igrowing/HA-Irrigator/hardware/irrigator box.stl

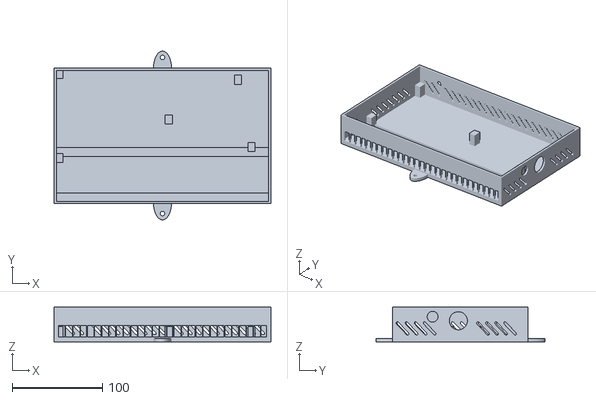
[picture p10: CAD file, 2026-07-20]
hardware/irrigator box.stl
240.0 x 186.7 x 38.7
