igrowing/HA-Irrigator/hardware/irrigator lid.stl

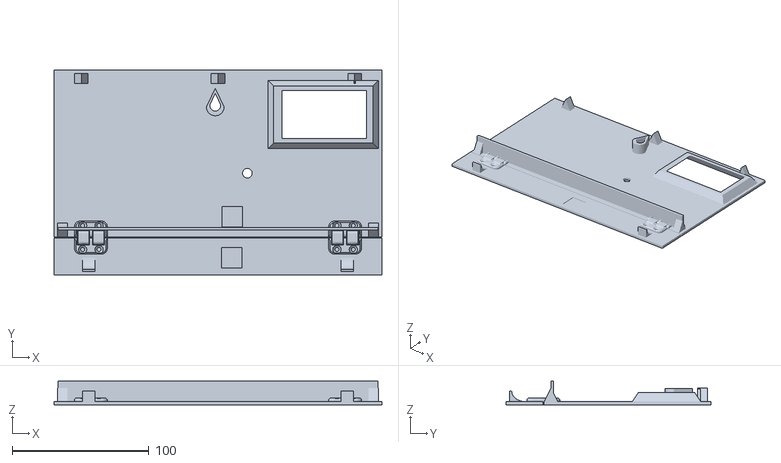
[picture p11: CAD file, 2026-07-20]
hardware/irrigator lid.stl
240.0 x 150.0 x 17.4
