igrowing/HA-Irrigator/docs/usage_homeassistant.md

# Home Assistant Usage

This is the end-user guide to the Garden tab once the HA package is installed. For installation steps (copying files, finding your device's MQTT prefix, dependencies, troubleshooting a package that won't load) see [integration.md](integration.md) — this page assumes that's done and focuses on what each part of the dashboard does day to day, plus how it behaves under the hood (sync, offline queueing, entity naming) once it's running.

The Irrigator unit itself, screen showing an upcoming scheduled run

## Status & Manual Control

One card per pump/zone (pump first, disabled zones hidden): a toggle — its label is the zone's real name, never "Zone N" — and a 1–120 minute duration slider. Flip the toggle on to start a run for whatever the slider is currently set to; flip it off to stop. A "Remaining" row shows minutes left on whichever zone/pump is actually running (the device only ever runs one thing at a time).

Status & Manual Control cards, pump plus two zones with duration sliders

Toggling on calls `script.irrigator_start` (publishes `cmd/run` with the slider's current value); toggling off calls `script.irrigator_stop`. Cards for disabled zones hide themselves via a `conditional` card keyed on that zone's `enabled` flag from `settings.json`. The toggle (`switch.irrigator_zone_N`) and "Remaining" (`sensor.irrigator_zone_N_remaining`) are two separate entities, both fed by `sensor.irrigator_watering_state` (the device's `/state` topic) — template `switch` entities can't carry a custom `remaining_min` attribute (see the header comment above the `template: switch:` block in `../homeassistant/packages/irrigator.yaml`), so it's its own sensor. Since the device only ever runs one zone/pump at a time, `/state` reports that single active one, and every switch/sensor pair is gated on "is this the zone `/state` currently says is active" — real minutes for whichever one is actually running, `0` for all others (shown rather than hidden, since entities-card rows can't be individually conditional).

**One deliberate exception**: `switch.irrigator_pump`/`switch.irrigator_zone_N` use `"Irrigator Zone N"` as their fallback instead of the `#N (no name)` placeholder used elsewhere (see **Settings** below). Reason: template `switch` entities don't support `default_entity_id` (see `irrigator.yaml`'s `template:` header comment), so nothing pins their `entity_id` directly — but `entity_id` is only ever auto-generated *once*, at first-ever creation, from whatever `name:` happens to render to at that exact moment. On a fresh deploy `sensor.irrigator_settings` has no data yet at that moment, so the fallback text is what actually gets slugified into the permanent `entity_id` — it has to slug to exactly `switch.irrigator_zone_N` (what everything else in this package references), which `#N (no name)` does not. This is a one-time, first-boot-only concern: every later re-render (once real names arrive, moments later) only updates the *displayed* name, never the already-frozen `entity_id` — so in practice you should only ever see "Irrigator Zone N" flash briefly right after the very first deploy, then never again. See "Troubleshooting" below if toggles/remaining time never reflect real state.

## History

A 7-day timeline (`history-graph`, `hours_to_show: 168`), one row per zone/pump, showing exactly when each ran. It references the switches directly — their name is live-templated (see **Status & Manual Control** above), and `history-graph` shows an entity's current registered name automatically, so no dashboard-side templating is needed here.

## Schedule

A read-only table of the device's current weekly schedule, sortable by day/zone/name/start/duration/active, plus an editor panel below it: pick an existing row (or "+ Add new"), set zone/day/start time/duration/active, then **Save** or **Delete**. Every edit republishes the whole schedule to the device — there's no partial update.

Device Schedule table, sorted by day

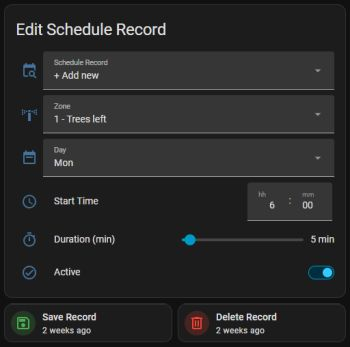
[picture p12: docs/edit schedule.jpg]
Edit Schedule Record panel, editing an existing record


Zone names, everywhere they appear (Status, History, Schedule, Settings), come from exactly one place: `sensor.irrigator_settings`'s `zone_names` attribute, sourced from the device's `settings.json` — never a hardcoded name. Until that sensor has real data, most zone-name fields show `#N (no name)` instead — a deliberate placeholder that doesn't look like a real name, so it's obvious at a glance when the device data hasn't loaded rather than silently passing off a fallback as if it were configured. See "Troubleshooting" below if you see that placeholder persist.

### How the schedule editor works

This section was originally built on Home Assistant's Local Calendar integration (`calendar.irrigator_zone_1`..`_11`, one event per schedule block, edited via the calendar's own dialog). That design turned out to be fundamentally blocked: `calendar.create_event` accepts `summary`, `description`, `start_date_time`/`end_date_time` (or `start_date`/`end_date`/`in`), and `location` — **no `rrule` field at all**. True weekly recurrence is a capability of the calendar dialog's own frontend code, not something exposed through any callable service, so no automation could ever have created a genuinely-recurring event, and a schedule made of only non-recurring single events would have silently gone stale the next time `calendar.get_events` scanned "this calendar week" and found nothing. If you still have the 11 Local Calendar integration entries from an earlier version of this setup, they're no longer referenced anywhere in this package and can be deleted (Settings > Devices & Services > Local Calendar).

The replacement edits `schedule.json`'s records directly — no calendar entities involved:

- **`sensor.irrigator_schedule`** mirrors whatever schedule the device currently has loaded (its   `records` attribute is a plain list of `{zone, day_of_week, start_time, duration_min, active}`   objects, same shape as `../ha.md`'s Schedule JSON example) — shown as the read-only "Device Schedule" table at the top of the Schedule section, sortable via the "Sort Schedule Table By" dropdown (see below for why that's a dropdown and not a clickable column header).
- **The editor panel** (`input_select.irrigator_schedule_picker` down to `input_boolean.irrigator_edit_active`) lets you pick an existing record or "+ Add new", edit zone/day/start time/duration/active, then press **"Save Schedule Record"** or **"Delete Schedule Record"**. Both scripts (`script.irrigator_schedule_save`/`_delete` in `../homeassistant/packages/irrigator.yaml`) read the *entire* current record list, apply one change (replace/append/remove), and republish the whole array to `cmd/upload/schedule.json` — same whole-file-replace contract every other write to this device uses. The picker's `[<index>]` prefix and the table's `#` column both refer to the same position in `sensor.irrigator_schedule`'s `records` list, so you can match a table row to its editor entry at a glance; two automations in `../homeassistant/packages/irrigator_automations.yaml` ("...rebuild schedule editor dropdown options" / "...load selected schedule record...") keep the picker's options and the panel's fields in sync with real device data.
- **Per-record "active" pause/resume is preserved directly** — unlike the calendar design, `active` is just a checkbox in the editor panel, matching the field's real meaning in `schedule.json`.
- **255-record cap.** `script.irrigator_schedule_save` checks the resulting record count against the firmware's `SCHEDULE_MAX_RECORDS` (255) before publishing, and raises a persistent notification instead of sending an oversized array that the firmware would whole-file-reject anyway.
- **No true click-a-column-header-to-sort.** A stock `markdown` card can't run JavaScript (HA sanitizes it out), so a real clickable sort isn't buildable without a custom/HACS card. `input_select.irrigator_schedule_sort_by` is the native equivalent — it only reorders the table's Jinja rendering, never touches `sensor.irrigator_schedule` or the device.
- **Dropdown options are built via Jinja's native-type list rendering** (a `namespace()` accumulator ending in a single bare `{{ ns.items }}` expression, which HA's template engine returns as an actual list rather than a stringified one) — this is a standard, common HA automation pattern, but if either `input_select.irrigator_schedule_picker` or `input_select.irrigator_edit_zone` ever shows one garbled option instead of several clean ones, check "Irrigator - rebuild schedule editor dropdown options" in `../homeassistant/packages/irrigator_automations.yaml` first.

## Settings

Settings section, watering adjustment, weather data, and zone name/enabled rows

The schedule-active toggle and watering-percentage number are live MQTT entities (direct topic round-trip). Zone name/enabled and default-manual-duration republish the *entire* `settings.json` via `script.irrigator_publish_settings` instead — a partial payload would be dangerous, since the firmware fills any missing field with its factory default, not with the value already on flash. This is guarded against the same virgin-deploy race as the schedule tab, but automatically rather than with a manual toggle — see **How the download/sync model works** below. Current-sensor calibration is separate from all of this — see **Current-Sensor Calibration** below.

- **Schedule Active** / **Watering Percentage** — direct controls, same as the device's own rotary menu. Watering Percentage is also the value weather-based auto-adjustment works once a day (see  below) — think of your own edits here as a same-day override, since the next daily cycle  recalculates and overwrites it. Although control on **Watering Percentage** is provided, the HA-Irrigateor takes care about it by Auto-adjustment algorithm.
- **Zone name / Enabled**, one row per zone — renaming or disabling a zone here updates the device  immediately (a disabled zone can't be started manually, by schedule, or via MQTT until  re-enabled). Disabling the zone is useful if you want to protect yourself for mistakes of setting irrelevant schedule. It also temporarily useful when you need to repair an electric or water cisruit of a certain zone or just perform mainenance on it.
- **Default Manual Duration** — how long a manual zone/pump run lasts when started without picking a duration.
- **Current-Sensor Calibration** — read-only **Valve Base Level** / **Pump Base Level** (from the last settings.json download), four **Alert Pump Under-current** / **Alert Pump Over-current** / **Alert Valve Under-current** / **Alert Valve Over-current** toggles, an **Irrigator Calibrate** button that captures fresh baselines (needs an active watering run — valve open, not just the pump alone — or the device rejects it), and the live **Last Calibration Response**. The base levels are device-owned — there's no HA control that edits them directly, only the button that triggers a fresh capture on the device; there's no local `input_number` for either value, editing them any other way isn't possible by design. See [technical.md](technical.md)'s **cmd/calibrate** section for what the base level means and how over/undercurrent alerting uses it.
  - The four alert toggles (default **on**) each independently enable/disable one of pump-over-current / pump-under-current / valve-over-current / valve-under-current alerting — same four switches as the device's own rotary Settings menu, right above **Calibrate CS** there too (see [usage_irrigator.md](usage_irrigator.md)'s **How to control over-current and under-current alerts**). Flipping one republishes the full `settings.json`, same as any other Settings-tab field. A toggle only has an effect once its sensor has actually been calibrated (a `0` base level means "never calibrated" — the underlying check is skipped regardless of the toggle).
  - Every alert that trips (`sensor.irrigator_last_alert`, or `.../alert` directly) is forwarded automatically to WhatsApp (`notify.greenapi`) and the Logbook by the "Irrigator - forward current-fault alerts to WhatsApp + logbook" automation in `../homeassistant/packages/irrigator_automations.yaml` — no dashboard action needed to receive them. That automation assumes a `notify.greenapi` service already exists in your Home Assistant (the [GreenAPI](https://green-api.com) WhatsApp integration, or any other notify target you rename it to) — if it doesn't, the automation's `notify.greenapi` step fails silently in the log without blocking the `logbook.log` step alongside it.
- **Auto-adjustment** — the master on/off switch for the whole weather-based feature (the daily percentage recalculation, including the forecast-rain term), topmost in the **Auto-adjustment  Weather Data** card. Turning it off freezes watering at whatever **Watering Percentage** is  currently set to — same as if the feature didn't exist — until turned back on. Mirrors the  device's own rotary UI, where it's the second item in the Settings menu (right after Schedule Active, since auto-adjustment only makes sense while the schedule itself is active).
- **Auto-adjustment Upper Limit** / **Lower Limit** — the range the daily weather-based adjustment  is allowed to move **Watering Percentage** within (defaults 200% / 40%). If the computed value  would fall below **Lower Limit**, that day's watering is skipped entirely (0%) instead of being  clamped up to it. The **Upper Limit** is intended to save an excessive bill on watering, trading off a bit the health of the plants.
- **Forecast Rain Probability Threshold** — the probability at or above which the rain in the forecast is counted, in full, as already fallen when the day's watering is calculated (default 70%). See [usage_irrigator.md](usage_irrigator.md)'s **Step 1** for the worked examples.
- **City** / **Coordinates** — read-only, whatever the device auto-detected from its IP address the  first time it came online with no saved location (there's no way to correct these from HA if the  IP-based lookup is inaccurate for your network — see [technical.md](technical.md)'s **Known limitations**). There's no HA equivalent of the device's own "Last update" field — that date lives in the  device's RAM only, never written to `settings.json`, so it's visible on the device's own rotary  UI Settings menu but not in Home Assistant.
- **Backup from the Irrigator Device** button (`button.irrigator_refresh_from_device`) calls `script.irrigator_backup_from_device` to force-request `/status` plus both `settings.json` and `schedule.json` on demand, regardless of virgin status — useful if you suspect drift or want to double-check after a manual device-side change. It also now writes both files to `/config/irrigator_backups/` on the HA host (a timestamped copy plus a `_latest.json` HA itself reads back from) — see **Backing up and restoring settings/schedule** below.
- **Restore to the Irrigator Device** button (`button.restore_to_the_irrigator_device`) uploads the files the button above last wrote back to the device, verbatim — see the same section below.

## Water Flow Sensing

The **Water Flow** card (Garden tab) shows the TUF-2000M flow meter's own running
total (`sensor.irrigator_flow_total`, L — the meter's lifetime totalizer, not a per-zone breakdown).
The live flow rate is deliberately not sent to Home Assistant; publish `cmd/meter` to see it. The **Water Consumption** card group
right below it splits that same lifetime volume per zone (`sensor.irrigator_zone_N_water_total`,
disabled zones' cards hidden the same way the Status section hides them) plus **Other**
(`sensor.irrigator_other_water_total` — flow measured while every valve is closed, e.g. a hose bib
spliced into the irrigation line or a leak; not a second whole-house meter), each shown as a rolling
24-hour total with a **History** button opening HA's native history dialog. All of these reset to 0
on a device reboot (RAM-only counters, like most of this project's runtime state) — HA's own
long-term statistics smooth over that reset rather than miscounting it as negative consumption.

Each completed run's own water use shows up as the `volume` attribute on
`sensor.irrigator_watering_state` (liters) the instant that run's `/state` message reports
`on: false` — `0` the rest of the time (while a zone/pump is running, or fully idle), so read it
right as a run ends rather than looking it up later; there's no dedicated dashboard card for it yet.

### Settings

The **Flow-Meter Anomaly Check** card (next to **Current-Sensor Calibration**) has:

- **Enabled** — master on/off for the anomaly check specifically (see below). Doesn't affect the
  Water Flow / Water Consumption telemetry above, which keeps reporting regardless of this toggle.
- **Expected Flow Rate** (L/min) — the steady-state rate the anomaly check compares live readings
  against. `0` (the default) means "not configured" — the check doesn't run until you set a real
  value here, e.g. the `flow_rate_lpm` that `cmd/meter` reports during a normal run.

Both fields republish the full `settings.json`, same as every other Settings-tab field (see **How
the download/sync model works** below).

### Flow anomaly alerts

While a zone is watering, the device compares the live flow rate against **Expected Flow Rate** and
warns you if it's noticeably higher or lower than normal:

- **Flow high** — a stuck-open valve elsewhere on the line, a burst pipe, or a valve letting through
  more than it should.
- **Flow low** — a clogged emitter/nozzle, a partially closed valve, or a valve that didn't fully
  open.

Like the current-sensor faults, each of these trips at most once per zone per calendar day, and is
forwarded automatically to WhatsApp and the Logbook by the same "Irrigator - forward current-fault
alerts to WhatsApp + logbook" automation (it matches on any `/alert` payload with a `fault` key
defined, and `flow_high`/`flow_low` use that same shape) — see **Settings** above for the
notify-service caveat. See [usage_irrigator.md](usage_irrigator.md)'s **Water Flow Sensing** section
for what these mean physically.

A Modbus communication failure (the flow meter not answering at all — a loose RS-485 connection, a
disconnected cable, a wedged transceiver) is a separate, lower-level alert
(`{"flow_meter":"failed",...}`, no `fault` key) that reaches `sensor.irrigator_last_alert` but is
**not** forwarded to WhatsApp — see [technical.md](technical.md)'s **Water flow sensing (TUF-2000M)**
section.

## How the download/sync model works

Per `../ha.md`'s preface, settings.json and schedule.json are requested from the device via MQTT —
but only when HA doesn't already have a representation, not on a recurring poll:

- **`sensor.irrigator_settings`** subscribes to `.../download/settings.json` (the response topic for `cmd/download/settings.json`) and simply reflects whatever last landed there — from an explicit request, or anyone else asking the device for it. There's no topic the device pushes settings.json to on its own, but there doesn't need to be: settings.json only ever changes via HA in practice (the local rotary/display menu has no settings-editing screens — see `../irrigator.md`'s menu spec), so once HA has a copy, HA's own edits (via `script.irrigator_publish_settings`) are the only thing that can make it stale, and HA already knows about those. "Irrigator - republish settings on local helper change" (the automation that calls that script) is itself guarded on this sensor already holding real data, which is what closes the settings-side virgin-deploy race automatically: the 15 Settings-tab helpers are created fresh at their YAML `initial:` placeholder values on a virgin deploy, and that creation fires a state-changed event just like a real edit would. This same sync automation also "self-sets" `switch.irrigator_schedule_active` (a `template:` entity — see **Offline command queue** below — whose `state:` reads the read-only `binary_sensor.irrigator_scheduled_state` MQTT echo sensor bound to `/scheduled`, which only ever gets a value when someone actively changes it, never as part of a passive settings download, so without this it'd sit blank on every fresh boot until manually touched) and `input_number.irrigator_watering_percentage` (a plain local helper, same as every other Settings-tab field — no echo dance needed there).
- **`sensor.irrigator_schedule`** is a trigger-based template sensor listening on *two* topics: `.../schedule` (which the device pushes on every change, whether from an HA upload or the device's own rotary/display menu) and `.../download/schedule.json` (the request/response topic). Since the device already pushes on every change, this sensor stays current on its own after the first value arrives — no polling needed.
- **"Irrigator - request initial data on virgin deploy"** (in `../homeassistant/packages/irrigator_automations.yaml`) fires both on HA startup AND whenever `binary_sensor.irrigator_online` turns "on" (covers the device reconnecting to the broker after an HA restart, which a startup-only trigger would miss entirely if the device isn't back online yet at that exact moment), and checks each of the two sensors independently: if either is still `unknown` (never received a value), it publishes an empty payload to that file's `cmd/download/...` topic to prime it. Once primed, it isn't re-requested automatically again.
- The **"Backup from the Irrigator Device"** button (`button.irrigator_refresh_from_device`) calls `script.irrigator_backup_from_device` to force-request `/status` plus both files on demand, regardless of virgin status — useful if you suspect drift or want to double-check after a manual device-side change.

## Backing up and restoring settings/schedule

- **"Backup from the Irrigator Device"** requests fresh `settings.json`/`schedule.json` from the device, waits (up to 15s each) for the responses, and writes each one — the exact bytes the device sent, not a re-serialized copy — to `/config/irrigator_backups/` on the HA host: `settings_<timestamp>.json` / `schedule_<timestamp>.json` for history, plus `settings_latest.json` / `schedule_latest.json` that Restore always reads. A device that answers one request but not the other (e.g. it reboots mid-response) still gets whichever one it did answer backed up — not an all-or-nothing failure. If a request times out, a persistent notification says so and the previous backup (if any) is left untouched.
- **"Restore to the Irrigator Device"** uploads `settings_latest.json`/`schedule_latest.json` back to the device via `cmd/upload/settings.json`/`cmd/upload/schedule.json` — the same verbatim bytes that were backed up, not a reconstruction from the Settings-tab helpers (that's what editing a field and letting `script.irrigator_publish_settings` republish does; it can only ever cover the fields those helpers expose). Routed through the offline command queue like every other device-bound write (see **Offline command queue** below), so a restore requested while the device is briefly unreachable is queued and retried rather than dropped. The dashboard button asks for confirmation first, since it overwrites the device's live settings and schedule with whatever was last backed up — if that's stale, restoring it reverts real changes.
  - `settings.json`'s device-owned fields — `schedule_active` and the two current-sensor calibration bases — are never actually changed by this: the firmware overwrites whatever an upload carries for them with its own current values before persisting (see [technical.md](technical.md)'s **JSON file formats**), so restoring an old backup can't accidentally flip the schedule off or wipe a calibration.
  - If no backup has ever been taken (`/config/irrigator_backups/` doesn't exist yet, or a file is empty), Restore says so via a persistent notification for that file and leaves the device untouched rather than uploading empty content.
  - Restore deliberately does not auto-refresh `sensor.irrigator_settings`/`sensor.irrigator_schedule` afterward — if the device was offline and the upload only got queued, an immediate re-backup would capture the device's *old* content and overwrite the very backup file Restore just read from. Press **"Backup from the Irrigator Device"** afterward to confirm the restore actually landed.
- Both buttons need a POSIX shell (`sh`) and standard coreutils (`cat`, `tee`, `mkdir`, `date`) on the HA host to read/write those files — true for Home Assistant OS, Supervised, and the official Docker image. If your `command_line:`/`shell_command:` entities show as unavailable, this is the first thing to check.

## Offline command queue

The garage's Wi-Fi is flaky enough that the device drops off `.../online` often, and the pre-queue behavior was every manual-control switch greying out via `availability:` whenever that happened — so all the Run switches and Schedule Active carry **no** `availability:` binding at all now; they're always clickable. Writing to any of them while the device is offline doesn't get lost — it's queued and retried until it actually reaches the device. Watering Percentage is a plain `input_number` helper (not gated by `availability:` either, since it isn't an MQTT entity at all) — editing it goes out via the same full-settings republish as every other Settings-tab field, which is itself queued the same way when offline:

- **`script.irrigator_enqueue_or_publish`** (`topic`, `payload`) is the one chokepoint every device-bound write goes through — `irrigator_start`, `irrigator_stop`, `irrigator_stop_all`, `irrigator_test_all`, `irrigator_publish_settings`, `irrigator_schedule_save`, `irrigator_schedule_delete`, and the `turn_on`/`turn_off` of the Schedule Active template switch above. If `binary_sensor.irrigator_online` is `on`, it publishes immediately — same latency as before this existed. If not, it fires an `irrigator_queue_push` event instead of publishing.
- **`sensor.irrigator_command_queue`** is a trigger-based template sensor that accumulates `{topic, payload}` entries in its `items` attribute, self-referencing its own previous value via `this.attributes.items` on every `irrigator_queue_push` (append one) or `irrigator_queue_pop` (drop the leading `count` entries). This lives as an *attribute*, not an entity `state` string, specifically so it isn't subject to HA's 255-character state-value limit — a queued `cmd/upload/settings.json` or `cmd/upload/schedule.json` payload can be several hundred bytes to a few KB, and a plain `input_text` helper couldn't hold that.
- **"Irrigator - flush pending command queue"** (in `../homeassistant/packages/irrigator_automations.yaml`) drains the queue whenever the device is reachable: triggered both by the online transition (fastest path) and a 30-second `time_pattern` safety net, so it keeps retrying for as long as the device stays online and anything remains queued — not just a single attempt on reconnect. It pops exactly one item at a time, immediately after publishing it, and re-checks `binary_sensor.irrigator_online` before every iteration — so a disconnect mid-batch stops the loop right there instead of firing the rest of a stale batch at a device that already stopped listening, and only items that actually got published are ever removed from the queue.
- There's no per-command delivery acknowledgement from the device for `cmd/run` / `cmd/stop` / `cmd/scheduled` / `cmd/upload/settings.json` (see [technical.md](technical.md)'s MQTT section) — `cmd/#` is delivered at QoS 0 in practice, and the broker can't hold QoS-0 messages for a disconnected client even with a persistent session. "Published to the broker while `binary_sensor.irrigator_online` said on" is the best success signal available; it's not a true device-side confirmation.
- **`irrigator_schedule_save`/`_delete`** build their new record list on top of the *last still-queued* `cmd/upload/schedule.json` payload if one exists (found by filtering `sensor.irrigator_command_queue`'s `items` for that topic), falling back to `sensor.irrigator_schedule.records` only when nothing's queued. This matters because `sensor.irrigator_schedule` only updates from the device's own echo on `.../schedule` — which won't arrive until it's back online — so without this, a second offline edit would silently overwrite the first instead of building on it.
- The dashboard shows `sensor.irrigator_command_queue` (its `state` is the pending count) both as a conditional tile at the top of "Status & Manual Control" (only visible when non-zero) and in the Diagnostics list, so it's obvious when a command hasn't reached the device yet.

## Entity naming reference

- `switch.irrigator_pump`, `switch.irrigator_zone_1`..`_11` - manual on/off control, name tracks the zone's configured name live (see the "deliberate exception" note under **Status & Manual Control** above for why its fallback text differs from everywhere else).
- `sensor.irrigator_pump_remaining`, `sensor.irrigator_zone_1_remaining`..`_11_remaining` - remaining minutes of the current run, `0` unless this zone/pump is the one currently active.
- `input_number.irrigator_pump_duration`, `..._zone_N_duration` - manual run duration, 1-120 min.
- `switch.irrigator_schedule_active` - `template:` entity, state read from a read-only MQTT echo sensor, writes routed through the offline command queue (see **Offline command queue** above) rather than a direct `command_topic`.
- `switch.irrigator_auto_adjustment` - master on/off for weather-based auto-adjustment, same `template:`-entity-over-echo-sensor pattern as `switch.irrigator_schedule_active` immediately above (backed by `binary_sensor.irrigator_auto_adjustment_state`, writes via `cmd/auto_adjustment`).
- `input_text.irrigator_zone_N_name`, `input_boolean.irrigator_zone_N_enabled`, `input_number.irrigator_default_manual_duration`, `input_number.irrigator_watering_percentage` - settings that require a full `settings.json` republish (see **How the download/sync model works** above).
- `button.irrigator_calibrate` - publishes `cmd/calibrate`; requires an active watering run (valve open) or the device rejects it via `/alert`.
- `input_boolean.irrigator_alert_pump_uc`, `..._pump_oc`, `..._valve_uc`, `..._valve_oc` - the four over/under-current alert toggles (`settings.json`'s `Current_sensor` group), synced/republished the same way as the other Settings-tab helpers.
- `sensor.irrigator_calibration_result` - live `cmd/calibrate` response (fires once per sensor: `sensor`, `base_level`, `sample_count`, `burst_samples_mv` as attributes). Read-only, not part of the `settings.json` republish - `valve_current_base_level`/`pump_current_base_level` are device-owned, same as `latitude`/`longitude`/`city`.
- `input_select.irrigator_schedule_picker`, `input_select.irrigator_edit_zone`, `input_select.irrigator_edit_day`, `input_datetime.irrigator_edit_start_time`, `input_number.irrigator_edit_duration_min`, `input_boolean.irrigator_edit_active` - the schedule editor panel's fields - see **How the schedule editor works** above.
- `input_select.irrigator_schedule_sort_by` - display-only sort order for the "Device Schedule" table.
- `button.irrigator_refresh_from_device` ("Backup from the Irrigator Device"), `button.restore_to_the_irrigator_device` ("Restore to the Irrigator Device" - entity_id derived from its `name:`, not from `unique_id: irrigator_restore_from_backup`), `button.irrigator_save_schedule_record`, `button.irrigator_delete_schedule_record`, `button.irrigator_stop_all` - manual triggers for the corresponding scripts.
- `sensor.irrigator_status`, `sensor.irrigator_watering_state`, `sensor.irrigator_last_alert`, `sensor.irrigator_queue`, `sensor.irrigator_schedule`, `binary_sensor.irrigator_online` - read-only device telemetry.
- `sensor.irrigator_flow_total` (L, the meter's own lifetime totalizer) - TUF-2000M flow-meter telemetry on the "Water Flow" card, published once/minute while watering and threshold-triggered while idle (see **Water flow sensing (TUF-2000M)** in [technical.md](technical.md)).
- `sensor.irrigator_zone_1_water_total`..`_11_water_total`, `sensor.irrigator_other_water_total` - lifetime (since-boot) liters per zone plus "other", on the "Water Consumption" card group - see **Water Flow Sensing** above.
- `input_boolean.irrigator_flow_meter_enabled`, `input_number.irrigator_expected_flow_rate_lpm` - the flow anomaly check's on/off toggle and threshold, on the "Flow-Meter Anomaly Check" card - see **Water Flow Sensing** above.

## Troubleshooting

**Many/most entities from this package show "not found"/"unavailable" in Lovelace at once, right after setup** (e.g. `sensor.irrigator_status`, `button.irrigator_stop_all_button`, even ones with no data dependency of their own): this is almost always an installation problem — the *whole package file* failed to load, not that those specific entities are individually broken. See
[integration.md](integration.md)'s **Troubleshooting** section for the log line to check and the most common cause (a leftover `irrigatorF4` placeholder). Fix whatever the log names and reload/restart — don't chase individual "missing" entities until the log is clean.

**Zone names show `#N (no name)` everywhere instead of real names, or toggles never reflect the device's actual on/off/watering state:** (once the above is ruled out) both point to the same root cause - `sensor.irrigator_settings` and/or `sensor.irrigator_watering_state` never received real MQTT data. Check, in order:

1. **Developer Tools > States** - look up `sensor.irrigator_settings` and `sensor.irrigator_watering_state`. Do they show attributes at all (e.g. `Zones`, `zone`, `on`, `pump`), or none/blank? No attributes means no MQTT message has ever arrived on that entity's topic.
2. **Is `irrigatorF4` actually your device's real prefix everywhere?** A mismatched prefix in even one of the three files (see [integration.md](integration.md)'s **Step 1**) means that file's entities silently subscribe to a topic nothing publishes to.
3. **Developer Tools > MQTT > Listen to a topic** - subscribe to `irrigatorF4/#` (your real prefix) and trigger a manual run from the device or its local UI. You should see messages on `.../state` the instant a valve/pump starts or stops. If nothing appears there at all, the problem is upstream of HA entirely (device not connected to this broker, wrong broker, etc.) - if messages DO appear there but the entities still don't update, the entity's `state_topic` doesn't match what you just saw.
4. Press **"Backup from the Irrigator Device"** (`script.irrigator_backup_from_device` - pulls `/status`, `settings.json`, and `schedule.json` in one go) and re-check `sensor.irrigator_settings` - if `Zones` still doesn't populate after confirming step 3 shows a real reply on `.../download/settings.json`, compare that raw payload against the expected shape in **JSON file formats** in [technical.md](technical.md).

**Your editor/IDE flags things like `Device '*irrigator_device' does not exist` or `Device 'variables:' does not exist`:** these are not from Home Assistant - check **Settings > System > Logs**; if it's clean, the package loaded and parsed successfully, which wouldn't be possible if these were real errors. This is almost certainly a VS Code HA extension (or similar YAML-linting tool) misreading constructs it doesn't fully support: the `device: *irrigator_device` YAML *anchor alias* (resolved by the YAML parser before HA ever sees it, which some lightweight linters don't do), and nested `variables:` steps inside a `repeat:` block. Safe to ignore as long as the real HA log is clean.

**A schedule dropdown (`input_select.irrigator_schedule_picker` or `input_select.irrigator_edit_zone`) shows one long garbled option instead of several clean ones:** the automation that builds its option list relies on HA's Jinja native-type rendering returning an actual list from a `namespace()` accumulator (see **How the schedule editor works** above) - check "Irrigator - rebuild schedule editor dropdown options" in `../homeassistant/packages/irrigator_automations.yaml` and confirm via Developer Tools > Actions > "Input select: Set options" that a plain list, not a string, is what's being sent.

For the weather fields specifically: if **City**/**Coordinates** never populate, the device hasn't yet had a successful ip-api.com lookup — check its own Settings menu (rotary UI) or `sensor.irrigator_settings`'s `location_known` attribute; if that's `false`, the device is still retrying every 5 minutes (needs Wi-Fi, and ip-api.com being reachable).
