igrowing/HA-Irrigator/hardware/schematics.pdf

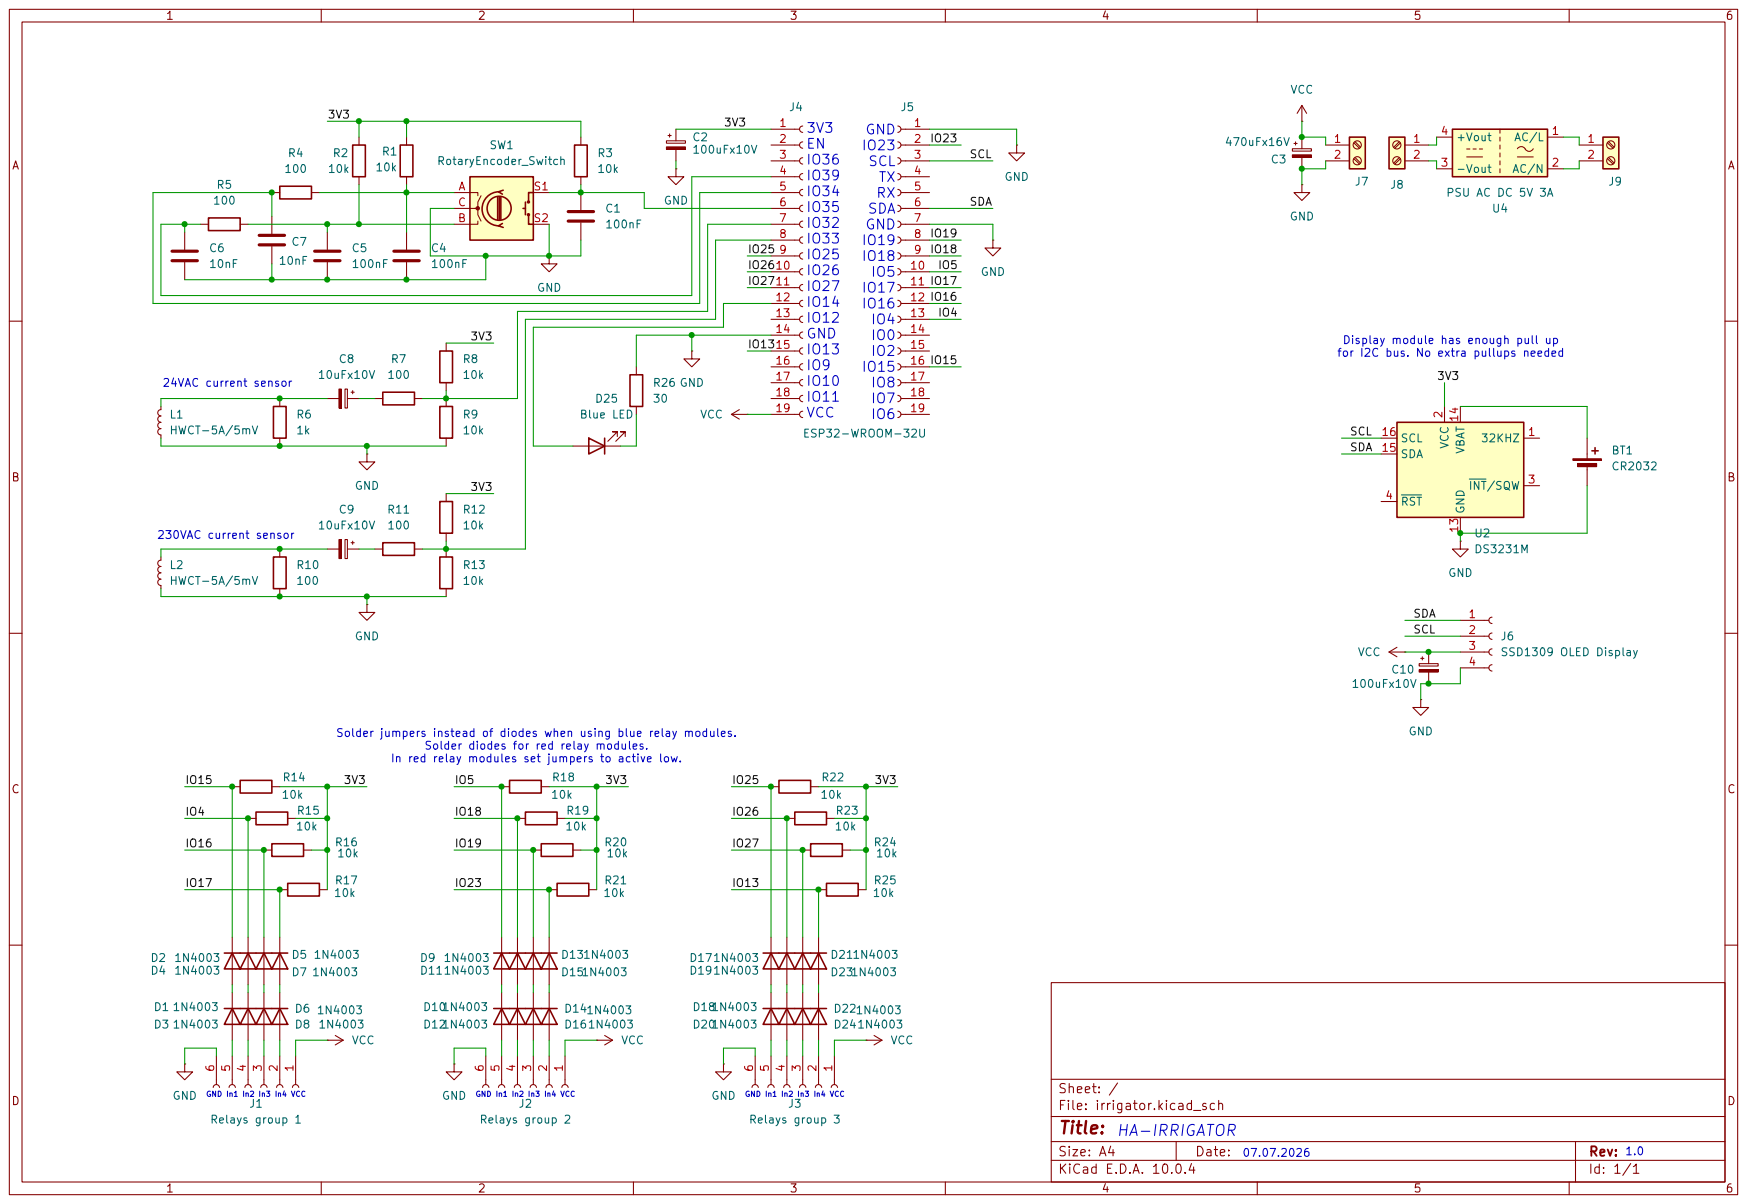
[picture p13: page 1]
