igrowing/HA-Irrigator/hardware/irrigator/irrigator.kicad_pcb

## KiCad design hardware/irrigator/irrigator.kicad_pcb (2026-07-20)

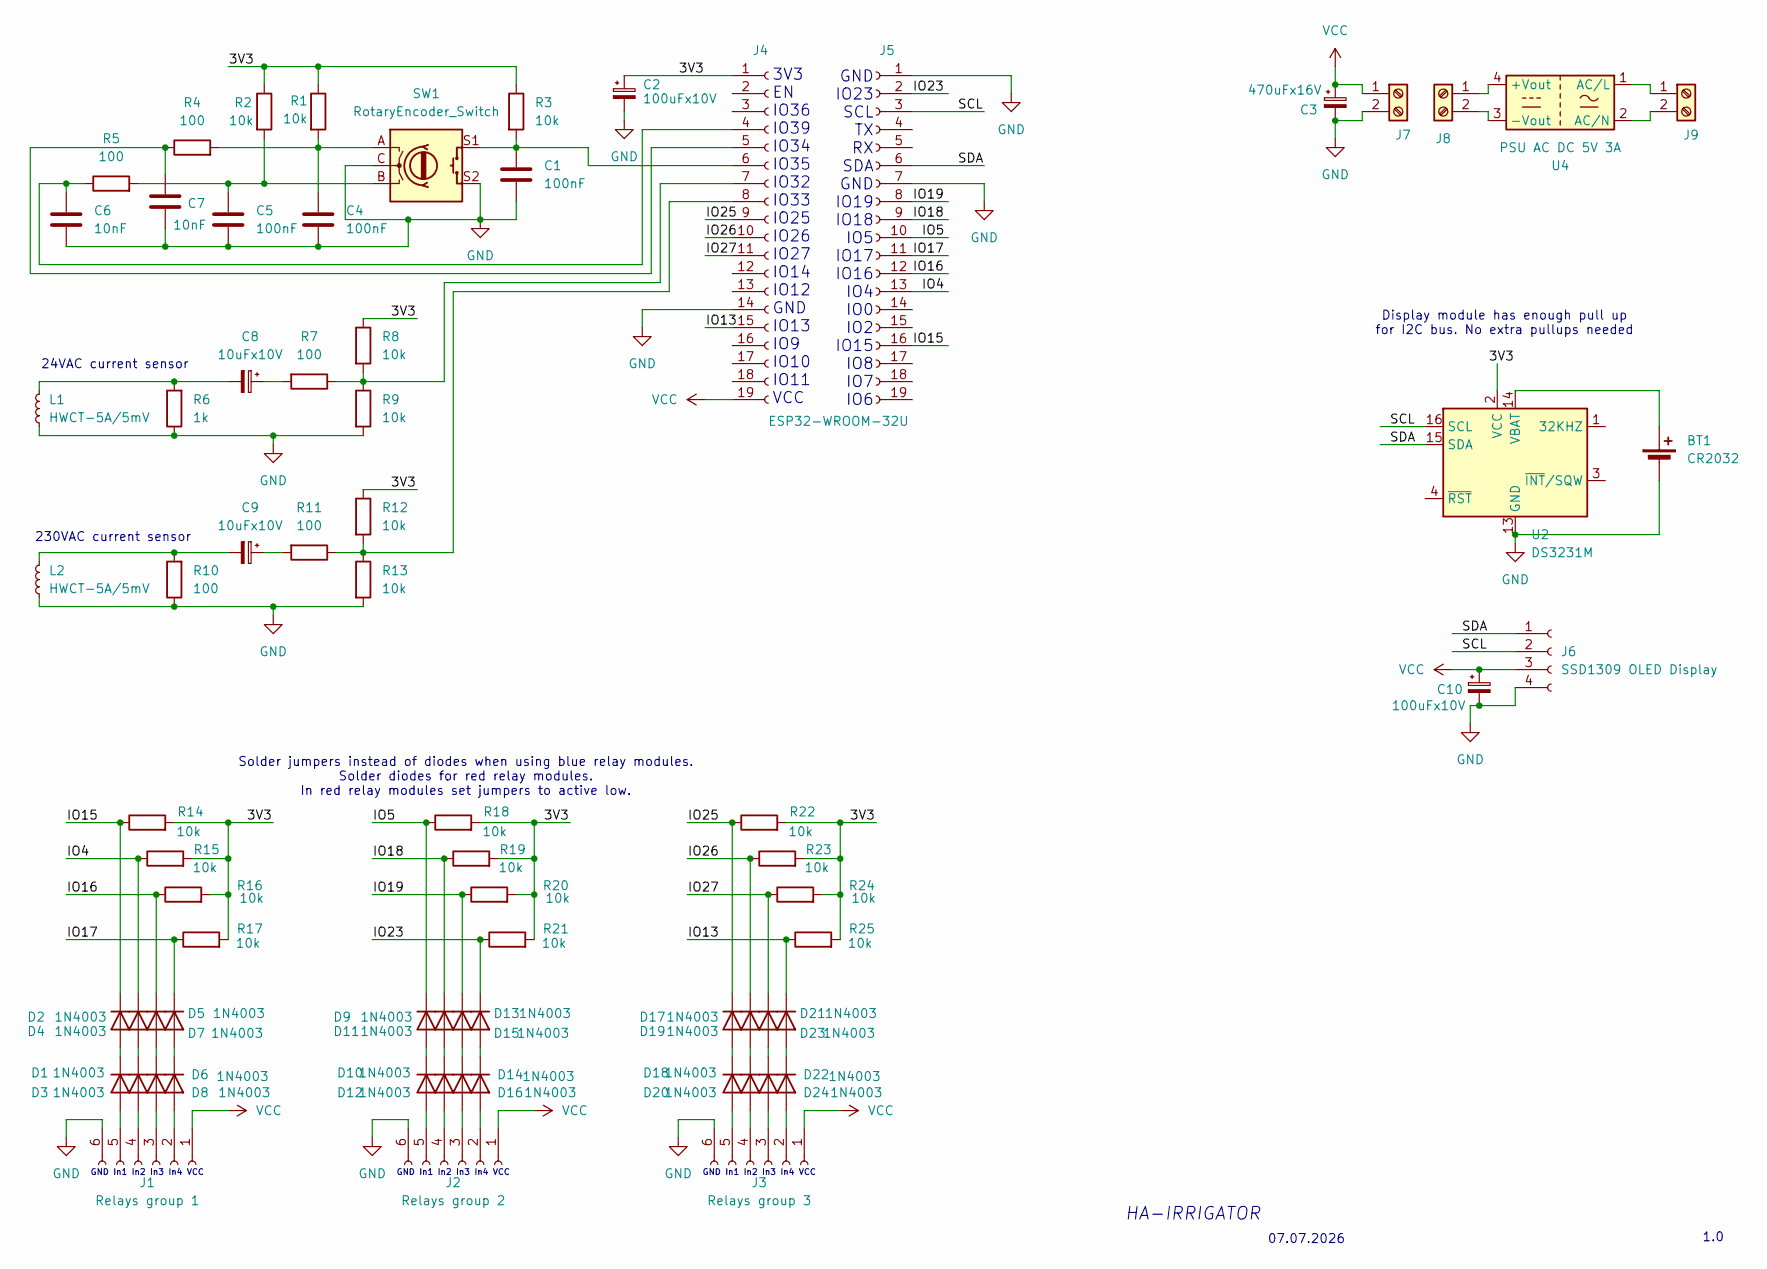
[picture p14: schematic irrigator.kicad_sch]

Parts:
BT1: CR2032; BatteryHolder_Keystone_3002_1x2032
C1, C4, C5: 100nF; C_0603_1608Metric
C2, C10: 100uFx10V; CP_EIA-1608-10_AVX-L
C3: 470uFx16V; C_1808_4520Metric
C6, C7: 10nF; C_0603_1608Metric
C8, C9: 10uFx10V; C_0805_2012Metric
D1, D2, D3, D4, D5, D6, D7, D8, D9, D10, D11, D12, D13, D14, D15, D16, D17, D18, D19, D20, D21, D22, D23, D24: 1N4003; D_DO-41_SOD81_P10.16mm_Horizontal
J1: Relays group 1; PinHeader_1x06_P2.54mm_Vertical
J2: Relays group 2; PinHeader_1x06_P2.54mm_Vertical
J3: Relays group 3; PinHeader_1x06_P2.54mm_Vertical
J4: PinHeader_1x19_P2.54mm_Vertical
J5: ESP32-WROOM-32U; PinHeader_1x19_P2.54mm_Vertical
J6: SSD1309 OLED Display; PinHeader_1x04_P2.54mm_Vertical
J7, J8, J9: TerminalBlock_MaiXu_MX126-5.0-02P_1x02_P5.00mm
L1, L2: HWCT-5A/5mV; L_Axial_L12.0mm_D5.0mm_P15.24mm_Horizontal_Fastron_MISC
R1, R2, R3, R8, R9, R12, R13, R14, R15, R16, R17, R18, R19, R20, R21, R22, R23, R24, R25: 10k; R_0603_1608Metric
R4, R5, R7, R10, R11: 100; R_0603_1608Metric
R6: 1k; R_0603_1608Metric
SW1: RotaryEncoder_Switch; RotaryEncoder_Alps_EC11E-Switch_Vertical_H20mm
U2: DS3231M; SOIC-16W_7.5x10.3mm_P1.27mm
U4: PSU AC DC 5V 3A; Converter_ACDC_Hi-Link_HLK-20Mxx

Connections:
/3V3: C2.1, J4.1, R1.1, R2.1, R3.1, R8.1, R12.1, R14.2, R15.2, R16.2, R17.2, R18.2, R19.2, R20.2, R21.2, R22.2, R23.2, R24.2, R25.2
/IO4: D4.1 (K), J5.13, R15.1
/IO5: D9.1 (K), J5.10, R18.1
/IO13: D23.1 (K), J4.15, R25.1
/IO15: D2.1 (K), J5.16, R14.1
/IO16: D5.1 (K), J5.12, R16.1
/IO17: D7.1 (K), J5.11, R17.1
/IO18: D11.1 (K), J5.9, R19.1
/IO19: D13.1 (K), J5.8, R20.1
/IO23: D15.1 (K), J5.2, R21.1
/IO25: D17.1 (K), J4.9, R22.1
/IO26: D19.1 (K), J4.10, R23.1
/IO27: D21.1 (K), J4.11, R24.1
/SCL: J5.3, J6.2, U2.16 (SCL)
/SDA: J5.6, J6.1, U2.15 (SDA)
GND: BT1.2 (-), C1.2, C2.2, C3.2, C4.2, C5.2, C6.2, C7.2, C10.2, J1.6, J2.6, J3.6, J4.14, J5.1, J5.7, J6.4, J7.2, L1.1, L2.1, R6.1, R9.2, R10.1, R13.2, SW1.C, SW1.S2, U2.5 (GND), U2.6 (GND), U2.7 (GND), U2.8 (GND), U2.9 (GND), U2.10 (GND), U2.11 (GND), U2.12 (GND), U2.13 (GND)
unnamed: BT1.1 (+), U2.14 (VBAT)
unnamed: C4.1, R1.2, R4.2, SW1.A
unnamed: C5.1, R2.2, R5.2, SW1.B
unnamed: C8.1, R7.2
unnamed: C8.2, L1.2, R6.2
unnamed: C9.1, R11.2
unnamed: C9.2, L2.2, R10.2
unnamed: D1.2 (A), J1.5
unnamed: D1.1 (K), D2.2 (A)
unnamed: D3.2 (A), J1.4
unnamed: D3.1 (K), D4.2 (A)
unnamed: D5.2 (A), D6.1 (K)
unnamed: D6.2 (A), J1.3
unnamed: D7.2 (A), D8.1 (K)
unnamed: D8.2 (A), J1.2
unnamed: D10.2 (A), J2.5
unnamed: D9.2 (A), D10.1 (K)
unnamed: D11.2 (A), D12.1 (K)
unnamed: D12.2 (A), J2.4
unnamed: D13.2 (A), D14.1 (K)
unnamed: D14.2 (A), J2.3
unnamed: D15.2 (A), D16.1 (K)
unnamed: D16.2 (A), J2.2
unnamed: D17.2 (A), D18.1 (K)
unnamed: D18.2 (A), J3.5
unnamed: D19.2 (A), D20.1 (K)
unnamed: D20.2 (A), J3.4
unnamed: D21.2 (A), D22.1 (K)
unnamed: D22.2 (A), J3.3
unnamed: D23.2 (A), D24.1 (K)
unnamed: D24.2 (A), J3.2
unnamed: C6.1, J4.4, R5.1
unnamed: C7.1, J4.5, R4.1
unnamed: C1.1, J4.6, R3.2, SW1.S1
unnamed: J4.7, R7.1, R8.2, R9.1
unnamed: J4.8, R11.1, R12.2, R13.1
unnamed: J8.1, U4.4 (+Vout)
unnamed: J8.2, U4.3 (-Vout)
unnamed: J9.1, U4.1 (AC/L)
unnamed: J9.2, U4.2 (AC/N)
VCC: C3.1, C10.1, J1.1, J2.1, J3.1, J4.19, J6.3, J7.1

Notes on the sheet:
GND In1 In2 In3 In4 VCC
1.0
Display module has enough pull up for I2C bus. No extra pullups needed
230VAC current sensor
Solder jumpers instead of diodes when using blue relay modules. Solder diodes for red relay modules. In red relay modules set jumpers to active low.
GND IO23 SCL TX RX SDA GND IO19 IO18 IO5 IO17 IO16 IO4 IO0 IO2 IO15 IO8 IO7 IO6
3V3 EN IO36 IO39 IO34 IO35 IO32 IO33 IO25 IO26 IO27 IO14 IO12 GND IO13 IO9 IO10 IO11 VCC
24VAC current sensor
HA-IRRIGATOR
07.07.2026

Board: 2 copper layers, 74 parts (0 on the bottom side), 57 nets, no tracks yet.
