igrowing/HA-Irrigator/homeassistant/packages/irrigator.yaml

# =============================================================================
# Irrigator - Home Assistant package (entities)
# =============================================================================
# BEFORE USE: replace every occurrence of `irrigatorF4` in this file (and in
# irrigator_automations.yaml / dashboards/garden_tab.yaml) with your device's
# real MQTT prefix: "irrigator" + the last 2 hex chars of its MAC address.
# Find it by watching `<something>/online` retained messages on your broker,
# or by publishing to `irrigator??/cmd/status` and seeing what answers.
#
# Assumes the `mqtt:` integration is already configured and connected to the
# same broker as the device - this package only adds entities, not a broker
# connection. See ../README.md for the full setup checklist.
# =============================================================================

# `device:` and `availability:` are per-entity options (nested inside each
# entity's own config dict, alongside name/state_topic/etc.) - NOT siblings
# of the domain key at the mqtt: list-item level. Every entity below aliases
# the same &irrigator_device / &irrigator_availability anchors (defined once,
# on the first entity that needs each) so there's still only one place to
# edit device metadata (e.g. "model") or the availability topic.
mqtt:
  # Device name is "Irrigator" (NOT "HA-Irrigator" or anything with
  # "Irrigator" repeated) *on purpose*, and every entity below that links to
  # this device drops the redundant leading "Irrigator " from its own
  # `name:` for the same reason: when an MQTT entity is linked to a
  # `device:`, HA generates its entity_id as
  # `slugify(device_name) + "_" + slugify(entity_name)` - "Irrigator" +
  # "Status" gives exactly `sensor.irrigator_status` (what everything else
  # in this package already references), whereas the earlier "HA-Irrigator"
  # device name + "Irrigator Status" entity name doubled up into
  # `sensor.ha_irrigator_irrigator_status` (confirmed on a live instance).
  binary_sensor:
    - name: "Online"
      unique_id: irrigator_online
      device_class: connectivity
      state_topic: "irrigatorF4/online"
      payload_on: "true"
      payload_off: "false"
      device: &irrigator_device
        identifiers: ["irrigatorF4"]
        name: "Irrigator"
        manufacturer: "DIY"
        model: "ESP32 Irrigation Controller"

    # Read-only echo of the device's own /scheduled topic. The interactive
    # switch.irrigator_schedule_active (template platform, further down)
    # reads its `state:` from this - kept separate so the switch itself can
    # go through script.irrigator_enqueue_or_publish instead of a plain
    # command_topic, and so it's never greyed out by `availability:`.
    - name: "Scheduled State"
      unique_id: irrigator_scheduled_state
      icon: mdi:calendar-check
      state_topic: "irrigatorF4/scheduled"
      payload_on: "true"
      payload_off: "false"
      device: *irrigator_device
      availability: &irrigator_availability
        - topic: "irrigatorF4/online"
          payload_available: "true"
          payload_not_available: "false"

    # Read-only echo of the device's own /auto_adjustment topic — same pattern as "Scheduled
    # State" above, feeding switch.irrigator_auto_adjustment (template platform, further down)
    # rather than the switch reading MQTT directly.
    - name: "Auto-adjustment State"
      unique_id: irrigator_auto_adjustment_state
      icon: mdi:weather-partly-rainy
      state_topic: "irrigatorF4/auto_adjustment"
      payload_on: "true"
      payload_off: "false"
      device: *irrigator_device
      availability: *irrigator_availability

  sensor:
    # Renamed to "Address" (not "Status") since its state is the device's
    # IP - this only changes the displayed friendly name, not entity_id
    # (already frozen as sensor.irrigator_status from first creation; see
    # the entity_id-freezing notes elsewhere in this file/README).
    - name: "Address"
      unique_id: irrigator_status
      icon: mdi:information-outline
      state_topic: "irrigatorF4/status"
      value_template: "{{ value_json.ip }}"
      json_attributes_topic: "irrigatorF4/status"
      device: *irrigator_device
      availability: *irrigator_availability

    # Live watering/pump status, per ha.md #1 ("update the status of cards
    # from the messages coming on topic <prefix>/state"). json_attributes_topic
    # makes every top-level key of the /state payload (zone, name, on, pump,
    # reason, scheduled, remaining_min) available via state_attr() - the
    # manual-control switches below read this, not a separate parse. If
    # toggles never reflect real device state, check (in this order):
    # (1) Developer Tools > States > sensor.irrigator_watering_state - does
    # it show attributes at all, or none/unknown? (2) if none, is the MQTT
    # integration actually connected to the same broker as the device, and
    # is `irrigatorF4` really this device's prefix (see header note)? use
    # Developer Tools > MQTT > Listen to a topic, subscribe to
    # `irrigatorF4/#`, and trigger a manual run to confirm the device
    # publishes at all. (3) if attributes DO show real data but a specific
    # switch still won't reflect it, check that switch's `state:` template
    # in the `template:` block below for a typo against the exact attribute
    # names here.
    - name: "Watering State"
      unique_id: irrigator_watering_state
      icon: mdi:sprinkler-variant
      state_topic: "irrigatorF4/state"
      value_template: "{{ 'watering' if (value_json.on or value_json.pump) else 'idle' }}"
      json_attributes_topic: "irrigatorF4/state"
      device: *irrigator_device
      availability: *irrigator_availability

    - name: "Last Alert"
      unique_id: irrigator_last_alert
      icon: mdi:alert-circle-outline
      state_topic: "irrigatorF4/alert"
      value_template: >-
        {{ value_json.message if value_json.message is defined else (value_json | tojson) }}
      json_attributes_topic: "irrigatorF4/alert"
      device: *irrigator_device
      availability: *irrigator_availability

    # cmd/calibrate's response — see docs/technical.md's "cmd/calibrate" section. Fires twice per
    # button press (once per sensor: valve, then pump), so this just shows whichever arrived last;
    # json_attributes_topic carries the full payload (sensor/base_level/sample_count/
    # burst_samples_mv — the last raw burst, for spotting ADC saturation) for anything needing more
    # than the headline number. The persisted base itself also round-trips into
    # sensor.irrigator_settings' valve_current_base_level/pump_current_base_level attributes on the
    # next settings.json download (e.g. "Backup from the Irrigator Device") — this sensor is the live response,
    # that one is the durable record.
    - name: "Calibration Result"
      unique_id: irrigator_calibration_result
      icon: mdi:tune-variant
      state_topic: "irrigatorF4/calibrate"
      value_template: "{{ value_json.sensor }}: {{ value_json.base_level }}"
      json_attributes_topic: "irrigatorF4/calibrate"
      device: *irrigator_device
      availability: *irrigator_availability

    # TUF-2000M flow-meter telemetry (see docs/technical.md's "Water flow sensing (TUF-2000M)"
    # section). The live flow rate is deliberately not published to HA (firmware-only, for anomaly
    # alerting; see cmd/meter for debugging) - publish cadence is once/minute while watering, threshold-triggered while idle, not
    # every Modbus poll. Also republished on every cmd/status (HA sends one on start, on device
    # reconnect and hourly), so HA relearns the total after its own restart even when idle.
    # Every sensor pulls the field it needs from the same /flow payload (total_liters, zone and
    # the per-zone counters below) via value_template; none of them sets json_attributes_topic,
    # so HA doesn't store the whole payload as attributes on each state change.

    # total_liters is the meter's own lifetime totalizer, not a per-run figure — see the
    # irrigator_zone_N_water_total / irrigator_other_water_total sensors below for the per-zone
    # breakdown, and sensor.irrigator_watering_state's `volume` attribute for a completed run's own
    # total (see docs/technical.md's "Water flow sensing (TUF-2000M)" section).
    - name: "Flow Total"
      unique_id: irrigator_flow_total
      icon: mdi:water
      state_topic: "irrigatorF4/flow"
      value_template: "{{ value_json.total_liters }}"
      unit_of_measurement: "L"
      state_class: total_increasing
      device: *irrigator_device
      availability: *irrigator_availability

    # Lifetime (since-boot) water consumption per zone plus "other" (flow measured while every
    # valve is closed - a hose bib spliced into the irrigation line, a leak - not a second
    # whole-house meter). Published on `/flow` (same message and cadence as Flow Total above), one
    # `zone_<n>` field per ENABLED zone only - value_json.get(..., 0) covers a zone that's currently disabled (its key is simply
    # absent from the payload) so the sensor reads 0 rather than "unknown".
    # `device_class: water` + `state_class: total_increasing` is what makes HA's recorder keep
    # long-term statistics for these - the "Water Consumption" dashboard group (garden_tab.yaml)
    # reads a rolling 24h window off those statistics, which survive a device reboot resetting this
    # RAM-only counter back to 0 (total_increasing tolerates a lower reading as a meter reset,
    # rather than miscounting it as negative consumption).
    - name: "Zone 1 Water Total"
      unique_id: irrigator_zone_1_water_total
      icon: mdi:water
      state_topic: "irrigatorF4/flow"
      value_template: "{{ value_json.get('zone_1', 0) }}"
      unit_of_measurement: "L"
      device_class: water
      state_class: total_increasing
      device: *irrigator_device
      availability: *irrigator_availability
    - name: "Zone 2 Water Total"
      unique_id: irrigator_zone_2_water_total
      icon: mdi:water
      state_topic: "irrigatorF4/flow"
      value_template: "{{ value_json.get('zone_2', 0) }}"
      unit_of_measurement: "L"
      device_class: water
      state_class: total_increasing
      device: *irrigator_device
      availability: *irrigator_availability
    - name: "Zone 3 Water Total"
      unique_id: irrigator_zone_3_water_total
      icon: mdi:water
      state_topic: "irrigatorF4/flow"
      value_template: "{{ value_json.get('zone_3', 0) }}"
      unit_of_measurement: "L"
      device_class: water
      state_class: total_increasing
      device: *irrigator_device
      availability: *irrigator_availability
    - name: "Zone 4 Water Total"
      unique_id: irrigator_zone_4_water_total
      icon: mdi:water
      state_topic: "irrigatorF4/flow"
      value_template: "{{ value_json.get('zone_4', 0) }}"
      unit_of_measurement: "L"
      device_class: water
      state_class: total_increasing
      device: *irrigator_device
      availability: *irrigator_availability
    - name: "Zone 5 Water Total"
      unique_id: irrigator_zone_5_water_total
      icon: mdi:water
      state_topic: "irrigatorF4/flow"
      value_template: "{{ value_json.get('zone_5', 0) }}"
      unit_of_measurement: "L"
      device_class: water
      state_class: total_increasing
      device: *irrigator_device
      availability: *irrigator_availability
    - name: "Zone 6 Water Total"
      unique_id: irrigator_zone_6_water_total
      icon: mdi:water
      state_topic: "irrigatorF4/flow"
      value_template: "{{ value_json.get('zone_6', 0) }}"
      unit_of_measurement: "L"
      device_class: water
      state_class: total_increasing
      device: *irrigator_device
      availability: *irrigator_availability
    - name: "Zone 7 Water Total"
      unique_id: irrigator_zone_7_water_total
      icon: mdi:water
      state_topic: "irrigatorF4/flow"
      value_template: "{{ value_json.get('zone_7', 0) }}"
      unit_of_measurement: "L"
      device_class: water
      state_class: total_increasing
      device: *irrigator_device
      availability: *irrigator_availability
    - name: "Zone 8 Water Total"
      unique_id: irrigator_zone_8_water_total
      icon: mdi:water
      state_topic: "irrigatorF4/flow"
      value_template: "{{ value_json.get('zone_8', 0) }}"
      unit_of_measurement: "L"
      device_class: water
      state_class: total_increasing
      device: *irrigator_device
      availability: *irrigator_availability
    - name: "Zone 9 Water Total"
      unique_id: irrigator_zone_9_water_total
      icon: mdi:water
      state_topic: "irrigatorF4/flow"
      value_template: "{{ value_json.get('zone_9', 0) }}"
      unit_of_measurement: "L"
      device_class: water
      state_class: total_increasing
      device: *irrigator_device
      availability: *irrigator_availability
    - name: "Zone 10 Water Total"
      unique_id: irrigator_zone_10_water_total
      icon: mdi:water
      state_topic: "irrigatorF4/flow"
      value_template: "{{ value_json.get('zone_10', 0) }}"
      unit_of_measurement: "L"
      device_class: water
      state_class: total_increasing
      device: *irrigator_device
      availability: *irrigator_availability
    - name: "Zone 11 Water Total"
      unique_id: irrigator_zone_11_water_total
      icon: mdi:water
      state_topic: "irrigatorF4/flow"
      value_template: "{{ value_json.get('zone_11', 0) }}"
      unit_of_measurement: "L"
      device_class: water
      state_class: total_increasing
      device: *irrigator_device
      availability: *irrigator_availability
    - name: "Other Water Total"
      unique_id: irrigator_other_water_total
      icon: mdi:water-alert-outline
      state_topic: "irrigatorF4/flow"
      value_template: "{{ value_json.get('other', 0) }}"
      unit_of_measurement: "L"
      device_class: water
      state_class: total_increasing
      device: *irrigator_device
      availability: *irrigator_availability

    - name: "Queue"
      unique_id: irrigator_queue
      icon: mdi:format-list-numbered
      state_topic: "irrigatorF4/queue"
      value_template: "{{ value_json | length }}"
      json_attributes_topic: "irrigatorF4/queue"
      json_attributes_template: "{{ {'items': value_json} | tojson }}"
      device: *irrigator_device
      availability: *irrigator_availability

    # Full settings.json snapshot - the ONLY source for zone names anywhere
    # in this dashboard (Terminology section of ha.md: never hardcode "Zone
    # N" as if it were a real name). Requested via cmd/download/settings.json
    # whenever HA doesn't have a value yet (on startup, AND whenever the
    # device (re)connects - see "Irrigator - request initial data on virgin
    # deploy" in irrigator_automations.yaml) and thereafter simply reflects
    # whatever last arrived on this topic. If zone names show as "#N (no
    # name)" (the explicit not-a-real-name placeholder used everywhere
    # below) instead of real names, check Developer Tools > States >
    # sensor.irrigator_settings - if its `zone_names` attribute is missing
    # entirely, this sensor has never received a payload; press "Refresh
    # From Device" and confirm via Developer Tools > MQTT > Listen to a
    # topic on `irrigatorF4/download/settings.json` that a reply actually
    # arrives.
    - name: "Settings"
      unique_id: irrigator_settings
      icon: mdi:cog-outline
      state_topic: "irrigatorF4/download/settings.json"
      value_template: "{{ value_json.Watering.watering_percentage }}"
      unit_of_measurement: "%"
      json_attributes_topic: "irrigatorF4/download/settings.json"
      device: *irrigator_device
      availability: *irrigator_availability

    # Read-only echo of the device's own /watering_percentage topic. No
    # longer what the interactive control reads its state from
    # (input_number.irrigator_watering_percentage, further down, is a plain
    # local helper instead - see its comment for why) - this sensor is now
    # purely a live display of whatever the device's current percentage
    # actually is, including changes the device makes on its own via
    # weather-driven auto-adjustment (main.ino's AutoAdjustment calls),
    # which the input_number only picks up on the next settings.json
    # (re)download.
    - name: "Watering Percentage Echo"
      unique_id: irrigator_watering_percentage_echo
      icon: mdi:water-percent
      state_topic: "irrigatorF4/watering_percentage"
      unit_of_measurement: "%"
      device: *irrigator_device
      availability: *irrigator_availability

    # Read-only echo of the device's own /skip_rain_until topic (published by
    # the cmd/skip_rain_until handler in main.ino). Payload is a bare, naive UTC
    # timestamp string ("2026-09-02T06:00:00", no zone suffix) - deliberately NOT given
    # device_class: timestamp here, since HA rejects a tz-naive value for that class; consumers
    # (sensor.irrigator_last_decision below) append "+00:00" before parsing, same as the
    # pump-remaining sensors. The topic is not retained and not re-seeded on reconnect, but the
    # mqtt integration restores this entity's last state across an HA restart, so the "Skip
    # until ..." decision survives one. No availability: block - a skip window that's still valid
    # should keep showing even if the device briefly drops off MQTT.
    - name: "Rain Skip Until"
      unique_id: irrigator_rain_skip_until
      icon: mdi:weather-rainy
      state_topic: "irrigatorF4/skip_rain_until"
      device: *irrigator_device

  # NOTE: the device-side mirror of schedule.json is a trigger-based template
  # sensor (sensor.irrigator_schedule, further down under `template:`), not a
  # plain `mqtt: sensor:` here - it needs to listen on two different topics
  # (the live push on every change, and the one-shot virgin-deploy download
  # response) and merge them into one entity, which a single `state_topic`
  # can't do.
  #
  # Schedule Active / Watering Percentage themselves are no longer plain
  # `mqtt: switch:` / `mqtt: number:` entities - their command side moved to
  # `template:` switch/number entities below (turn_on/turn_off/set_value
  # calling script.irrigator_enqueue_or_publish) so a write made while
  # offline can be queued instead of silently dropped, and so they're never
  # greyed out by `availability:`. See "Scheduled State" / "Watering
  # Percentage Echo" above for the plain sensors that still mirror the
  # device's own echo on those two topics.

# -----------------------------------------------------------------------
# Manual-control switches (part 1 of the Garden tab): one per pump/zone,
# reflecting the live `state` topic and starting/stopping via the scripts
# below (cmd/run needs a JSON body with a duration, which a plain MQTT
# switch payload_on can't provide - hence template switches + scripts
# instead of plain `mqtt: switch:` entries here).
#
# `name:` IS templated to the live zone name (same "#N (no name)"-style
# fallback pattern as everywhere else)... except the fallback text below is
# NOT "#N (no name)" like elsewhere - it's "Irrigator Zone N". Reason:
# template `switch` doesn't support `default_entity_id` (confirmed via a
# live DisallowedExtraPropWarning), so nothing pins entity_id directly - but
# entity_id is only ever auto-generated ONCE, at the entity's first-ever
# creation, from whatever `name:` renders to AT THAT MOMENT; every later
# re-render (once real zone names arrive) only updates the displayed name,
# never the frozen entity_id. On a fresh deploy, sensor.irrigator_settings
# has no data yet at that first moment, so the fallback text is what
# actually gets slugified into the permanent switch.irrigator_zone_N -
# hence a fallback chosen to slug to exactly that ("Irrigator Zone 1" ->
# "irrigator_zone_1"), not the generic "#N (no name)" placeholder used
# elsewhere (which would slug to something unrelated and permanently wrong).
# One edge case this doesn't cover: if sensor.irrigator_settings already
# holds real cached data the very first time these specific switch configs
# are ever loaded (e.g. added to an installation that's had this package
# running for a while under a different entity set), the real name would be
# used for that first slug instead, and entity_id could come out as
# something other than switch.irrigator_zone_N. Not a concern for a fresh
# deploy (the normal case), but worth knowing if this file is ever
# restructured later on a long-running instance.
# `remaining_min` still can't live on the switch as `attributes:` (same
# restriction, unrelated to naming) - see the dedicated sensor.irrigator_*_remaining
# entities further down for that.
#
# No `availability:` on any of these (deliberately, on flaky Wi-Fi where the
# device drops offline often) - turn_on/turn_off go through
# script.irrigator_start/irrigator_stop, which route through
# script.irrigator_enqueue_or_publish and queue on sensor.irrigator_command_queue
# when the device is offline instead of publishing straight away. See
# "Offline command queue" in ../README.md for the full mechanism.
# -----------------------------------------------------------------------
template:
  - switch:
      - name: "Irrigator Pump"
        unique_id: irrigator_switch_pump
        icon: mdi:pump
        state: "{{ state_attr('sensor.irrigator_watering_state', 'pump') | default(false) }}"
        turn_on:
          - action: script.irrigator_start
            data:
              zone: 0
              duration: "{{ states('input_number.irrigator_pump_duration') | int(5) }}"
        turn_off:
          - action: script.irrigator_stop

      - name: >-
          {{ ('1. ' ~ (state_attr('sensor.irrigator_settings', 'Zones') or {}).get('1', {}).get('name')) if (state_attr('sensor.irrigator_settings', 'Zones') or {}).get('1', {}).get('name') else 'Irrigator Zone 1' }}
        unique_id: irrigator_switch_zone_1
        icon: mdi:sprinkler-variant
        state: "{{ state_attr('sensor.irrigator_watering_state', 'zone') == 1 and (state_attr('sensor.irrigator_watering_state', 'on') | default(false)) }}"
        turn_on:
          - action: script.irrigator_start
            data: {zone: 1, duration: "{{ states('input_number.irrigator_zone_1_duration') | int(5) }}"}
        turn_off:
          - action: script.irrigator_stop

      - name: >-
          {{ ('2. ' ~ (state_attr('sensor.irrigator_settings', 'Zones') or {}).get('2', {}).get('name')) if (state_attr('sensor.irrigator_settings', 'Zones') or {}).get('2', {}).get('name') else 'Irrigator Zone 2' }}
        unique_id: irrigator_switch_zone_2
        icon: mdi:sprinkler-variant
        state: "{{ state_attr('sensor.irrigator_watering_state', 'zone') == 2 and (state_attr('sensor.irrigator_watering_state', 'on') | default(false)) }}"
        turn_on:
          - action: script.irrigator_start
            data: {zone: 2, duration: "{{ states('input_number.irrigator_zone_2_duration') | int(5) }}"}
        turn_off:
          - action: script.irrigator_stop

      - name: >-
          {{ ('3. ' ~ (state_attr('sensor.irrigator_settings', 'Zones') or {}).get('3', {}).get('name')) if (state_attr('sensor.irrigator_settings', 'Zones') or {}).get('3', {}).get('name') else 'Irrigator Zone 3' }}
        unique_id: irrigator_switch_zone_3
        icon: mdi:sprinkler-variant
        state: "{{ state_attr('sensor.irrigator_watering_state', 'zone') == 3 and (state_attr('sensor.irrigator_watering_state', 'on') | default(false)) }}"
        turn_on:
          - action: script.irrigator_start
            data: {zone: 3, duration: "{{ states('input_number.irrigator_zone_3_duration') | int(5) }}"}
        turn_off:
          - action: script.irrigator_stop

      - name: >-
          {{ ('4. ' ~ (state_attr('sensor.irrigator_settings', 'Zones') or {}).get('4', {}).get('name')) if (state_attr('sensor.irrigator_settings', 'Zones') or {}).get('4', {}).get('name') else 'Irrigator Zone 4' }}
        unique_id: irrigator_switch_zone_4
        icon: mdi:sprinkler-variant
        state: "{{ state_attr('sensor.irrigator_watering_state', 'zone') == 4 and (state_attr('sensor.irrigator_watering_state', 'on') | default(false)) }}"
        turn_on:
          - action: script.irrigator_start
            data: {zone: 4, duration: "{{ states('input_number.irrigator_zone_4_duration') | int(5) }}"}
        turn_off:
          - action: script.irrigator_stop

      - name: >-
          {{ ('5. ' ~ (state_attr('sensor.irrigator_settings', 'Zones') or {}).get('5', {}).get('name')) if (state_attr('sensor.irrigator_settings', 'Zones') or {}).get('5', {}).get('name') else 'Irrigator Zone 5' }}
        unique_id: irrigator_switch_zone_5
        icon: mdi:sprinkler-variant
        state: "{{ state_attr('sensor.irrigator_watering_state', 'zone') == 5 and (state_attr('sensor.irrigator_watering_state', 'on') | default(false)) }}"
        turn_on:
          - action: script.irrigator_start
            data: {zone: 5, duration: "{{ states('input_number.irrigator_zone_5_duration') | int(5) }}"}
        turn_off:
          - action: script.irrigator_stop

      - name: >-
          {{ ('6. ' ~ (state_attr('sensor.irrigator_settings', 'Zones') or {}).get('6', {}).get('name')) if (state_attr('sensor.irrigator_settings', 'Zones') or {}).get('6', {}).get('name') else 'Irrigator Zone 6' }}
        unique_id: irrigator_switch_zone_6
        icon: mdi:sprinkler-variant
        state: "{{ state_attr('sensor.irrigator_watering_state', 'zone') == 6 and (state_attr('sensor.irrigator_watering_state', 'on') | default(false)) }}"
        turn_on:
          - action: script.irrigator_start
            data: {zone: 6, duration: "{{ states('input_number.irrigator_zone_6_duration') | int(5) }}"}
        turn_off:
          - action: script.irrigator_stop

      - name: >-
          {{ ('7. ' ~ (state_attr('sensor.irrigator_settings', 'Zones') or {}).get('7', {}).get('name')) if (state_attr('sensor.irrigator_settings', 'Zones') or {}).get('7', {}).get('name') else 'Irrigator Zone 7' }}
        unique_id: irrigator_switch_zone_7
        icon: mdi:sprinkler-variant
        state: "{{ state_attr('sensor.irrigator_watering_state', 'zone') == 7 and (state_attr('sensor.irrigator_watering_state', 'on') | default(false)) }}"
        turn_on:
          - action: script.irrigator_start
            data: {zone: 7, duration: "{{ states('input_number.irrigator_zone_7_duration') | int(5) }}"}
        turn_off:
          - action: script.irrigator_stop

      - name: >-
          {{ ('8. ' ~ (state_attr('sensor.irrigator_settings', 'Zones') or {}).get('8', {}).get('name')) if (state_attr('sensor.irrigator_settings', 'Zones') or {}).get('8', {}).get('name') else 'Irrigator Zone 8' }}
        unique_id: irrigator_switch_zone_8
        icon: mdi:sprinkler-variant
        state: "{{ state_attr('sensor.irrigator_watering_state', 'zone') == 8 and (state_attr('sensor.irrigator_watering_state', 'on') | default(false)) }}"
        turn_on:
          - action: script.irrigator_start
            data: {zone: 8, duration: "{{ states('input_number.irrigator_zone_8_duration') | int(5) }}"}
        turn_off:
          - action: script.irrigator_stop

      - name: >-
          {{ ('9. ' ~ (state_attr('sensor.irrigator_settings', 'Zones') or {}).get('9', {}).get('name')) if (state_attr('sensor.irrigator_settings', 'Zones') or {}).get('9', {}).get('name') else 'Irrigator Zone 9' }}
        unique_id: irrigator_switch_zone_9
        icon: mdi:sprinkler-variant
        state: "{{ state_attr('sensor.irrigator_watering_state', 'zone') == 9 and (state_attr('sensor.irrigator_watering_state', 'on') | default(false)) }}"
        turn_on:
          - action: script.irrigator_start
            data: {zone: 9, duration: "{{ states('input_number.irrigator_zone_9_duration') | int(5) }}"}
        turn_off:
          - action: script.irrigator_stop

      - name: >-
          {{ ('10. ' ~ (state_attr('sensor.irrigator_settings', 'Zones') or {}).get('10', {}).get('name')) if (state_attr('sensor.irrigator_settings', 'Zones') or {}).get('10', {}).get('name') else 'Irrigator Zone 10' }}
        unique_id: irrigator_switch_zone_10
        icon: mdi:sprinkler-variant
        state: "{{ state_attr('sensor.irrigator_watering_state', 'zone') == 10 and (state_attr('sensor.irrigator_watering_state', 'on') | default(false)) }}"
        turn_on:
          - action: script.irrigator_start
            data: {zone: 10, duration: "{{ states('input_number.irrigator_zone_10_duration') | int(5) }}"}
        turn_off:
          - action: script.irrigator_stop

      - name: >-
          {{ ('11. ' ~ (state_attr('sensor.irrigator_settings', 'Zones') or {}).get('11', {}).get('name')) if (state_attr('sensor.irrigator_settings', 'Zones') or {}).get('11', {}).get('name') else 'Irrigator Zone 11' }}
        unique_id: irrigator_switch_zone_11
        icon: mdi:sprinkler-variant
        state: "{{ state_attr('sensor.irrigator_watering_state', 'zone') == 11 and (state_attr('sensor.irrigator_watering_state', 'on') | default(false)) }}"
        turn_on:
          - action: script.irrigator_start
            data: {zone: 11, duration: "{{ states('input_number.irrigator_zone_11_duration') | int(5) }}"}
        turn_off:
          - action: script.irrigator_stop

  # Schedule Active: template version of the entity that used to be a plain
  # `mqtt: switch:` (see the NOTE in the `mqtt:` block above). `state:` reads
  # the device's own echo via the read-only sensor added there; writes go
  # through script.irrigator_enqueue_or_publish instead of a raw
  # command_topic so they queue for retry when offline, and it carries no
  # `availability:` so it's never greyed out.
  #
  # Watering Percentage is NOT a sibling of this (despite both being direct
  # MQTT entities historically) - it's now input_number.irrigator_watering_percentage
  # (see `input_number:` below), a plain local helper like every other
  # settings.json field, republished via script.irrigator_publish_settings
  # instead of its own cmd/watering_percentage topic. See that helper's
  # comment for why: cmd/watering_percentage still exists on the firmware
  # side (main.ino's `commandName == "watering_percentage"`) for direct/manual
  # MQTT use, but nothing in this package publishes to it anymore.
  - switch:
      # `name:` deliberately includes the "Irrigator " prefix (matching the
      # pump/zone switches above, not the mqtt: platform's device-linked
      # entities below) - this platform has no `device:` grouping in this
      # file, so entity_id is a plain slugify(name); without the prefix this
      # would register as switch.schedule_active instead of the
      # switch.irrigator_schedule_active every script/automation/dashboard
      # card here already references.
      - name: "Irrigator Schedule Active"
        unique_id: irrigator_schedule_active
        icon: mdi:calendar-check
        state: "{{ is_state('binary_sensor.irrigator_scheduled_state', 'on') }}"
        turn_on:
          - action: script.irrigator_enqueue_or_publish
            data: {topic: "irrigatorF4/cmd/scheduled", payload: "true"}
        turn_off:
          - action: script.irrigator_enqueue_or_publish
            data: {topic: "irrigatorF4/cmd/scheduled", payload: "false"}

      # Master on/off for weather-based auto-adjustment (both the daily percentage recalculation
      # and the forecast-rain term) — same template-switch-over-echo-sensor pattern as "Irrigator
      # Schedule Active" above, for the same reason: writes go through
      # script.irrigator_enqueue_or_publish so they queue for retry when offline, and it carries
      # no `availability:` so it's never greyed out.
      #
      # Unlike "Irrigator Schedule Active", the echo topic behind it
      # (binary_sensor.irrigator_auto_adjustment_state / irrigatorF4/auto_adjustment) is NOT
      # retained on the broker (deliberate, see MqttService::publishAutoAdjustmentEnabled), and
      # the device only re-seeds it on its OWN MQTT reconnect. So after an HA-only restart while
      # the device stays connected, that binary_sensor is 'unknown' and this switch would read
      # off even when auto-adjustment is on. Fall back to the auto_adjustment_enabled key of the
      # /status payload, which the "Irrigator - request data" automation re-requests via
      # cmd/status on every HA start / device-reconnect.
      - name: "Irrigator Auto-adjustment"
        unique_id: irrigator_auto_adjustment
        icon: mdi:weather-partly-rainy
        state: >-
          {% set echo = states('binary_sensor.irrigator_auto_adjustment_state') %}
          {% if echo in ['on', 'off'] %}
            {{ echo == 'on' }}
          {% else %}
            {{ state_attr('sensor.irrigator_address_2', 'auto_adjustment_enabled') | default(false, true) }}
          {% endif %}
        turn_on:
          - action: script.irrigator_enqueue_or_publish
            data: {topic: "irrigatorF4/cmd/auto_adjustment", payload: "true"}
        turn_off:
          - action: script.irrigator_enqueue_or_publish
            data: {topic: "irrigatorF4/cmd/auto_adjustment", payload: "false"}

  - binary_sensor:
      # Zone-enabled flags (unrelated to watering activity, which the
      # switches above already cover live). default_entity_id/attributes
      # here are unaffected by the switch-specific restriction discussed
      # above.
      - name: >-
          {{ (state_attr('sensor.irrigator_settings', 'Zones') or {}).get('1', {}).get('name', '#1 (no name)') }} Enabled
        unique_id: irrigator_zone_1_enabled_sensor
        default_entity_id: binary_sensor.irrigator_zone_1_enabled_sensor
        state: "{{ (state_attr('sensor.irrigator_settings', 'Zones') or {}).get('1', {}).get('enabled', true) }}"
      - name: >-
          {{ (state_attr('sensor.irrigator_settings', 'Zones') or {}).get('2', {}).get('name', '#2 (no name)') }} Enabled
        unique_id: irrigator_zone_2_enabled_sensor
        default_entity_id: binary_sensor.irrigator_zone_2_enabled_sensor
        state: "{{ (state_attr('sensor.irrigator_settings', 'Zones') or {}).get('2', {}).get('enabled', true) }}"
      - name: >-
          {{ (state_attr('sensor.irrigator_settings', 'Zones') or {}).get('3', {}).get('name', '#3 (no name)') }} Enabled
        unique_id: irrigator_zone_3_enabled_sensor
        default_entity_id: binary_sensor.irrigator_zone_3_enabled_sensor
        state: "{{ (state_attr('sensor.irrigator_settings', 'Zones') or {}).get('3', {}).get('enabled', true) }}"
      - name: >-
          {{ (state_attr('sensor.irrigator_settings', 'Zones') or {}).get('4', {}).get('name', '#4 (no name)') }} Enabled
        unique_id: irrigator_zone_4_enabled_sensor
        default_entity_id: binary_sensor.irrigator_zone_4_enabled_sensor
        state: "{{ (state_attr('sensor.irrigator_settings', 'Zones') or {}).get('4', {}).get('enabled', true) }}"
      - name: >-
          {{ (state_attr('sensor.irrigator_settings', 'Zones') or {}).get('5', {}).get('name', '#5 (no name)') }} Enabled
        unique_id: irrigator_zone_5_enabled_sensor
        default_entity_id: binary_sensor.irrigator_zone_5_enabled_sensor
        state: "{{ (state_attr('sensor.irrigator_settings', 'Zones') or {}).get('5', {}).get('enabled', true) }}"
      - name: >-
          {{ (state_attr('sensor.irrigator_settings', 'Zones') or {}).get('6', {}).get('name', '#6 (no name)') }} Enabled
        unique_id: irrigator_zone_6_enabled_sensor
        default_entity_id: binary_sensor.irrigator_zone_6_enabled_sensor
        state: "{{ (state_attr('sensor.irrigator_settings', 'Zones') or {}).get('6', {}).get('enabled', true) }}"
      - name: >-
          {{ (state_attr('sensor.irrigator_settings', 'Zones') or {}).get('7', {}).get('name', '#7 (no name)') }} Enabled
        unique_id: irrigator_zone_7_enabled_sensor
        default_entity_id: binary_sensor.irrigator_zone_7_enabled_sensor
        state: "{{ (state_attr('sensor.irrigator_settings', 'Zones') or {}).get('7', {}).get('enabled', true) }}"
      - name: >-
          {{ (state_attr('sensor.irrigator_settings', 'Zones') or {}).get('8', {}).get('name', '#8 (no name)') }} Enabled
        unique_id: irrigator_zone_8_enabled_sensor
        default_entity_id: binary_sensor.irrigator_zone_8_enabled_sensor
        state: "{{ (state_attr('sensor.irrigator_settings', 'Zones') or {}).get('8', {}).get('enabled', true) }}"
      - name: >-
          {{ (state_attr('sensor.irrigator_settings', 'Zones') or {}).get('9', {}).get('name', '#9 (no name)') }} Enabled
        unique_id: irrigator_zone_9_enabled_sensor
        default_entity_id: binary_sensor.irrigator_zone_9_enabled_sensor
        state: "{{ (state_attr('sensor.irrigator_settings', 'Zones') or {}).get('9', {}).get('enabled', true) }}"
      - name: >-
          {{ (state_attr('sensor.irrigator_settings', 'Zones') or {}).get('10', {}).get('name', '#10 (no name)') }} Enabled
        unique_id: irrigator_zone_10_enabled_sensor
        default_entity_id: binary_sensor.irrigator_zone_10_enabled_sensor
        state: "{{ (state_attr('sensor.irrigator_settings', 'Zones') or {}).get('10', {}).get('enabled', true) }}"
      - name: >-
          {{ (state_attr('sensor.irrigator_settings', 'Zones') or {}).get('11', {}).get('name', '#11 (no name)') }} Enabled
        unique_id: irrigator_zone_11_enabled_sensor
        default_entity_id: binary_sensor.irrigator_zone_11_enabled_sensor
        state: "{{ (state_attr('sensor.irrigator_settings', 'Zones') or {}).get('11', {}).get('enabled', true) }}"

  # Remaining-minutes counters, one per pump/zone - moved out of the
  # switches' `attributes:` (switch doesn't support that key) into their own
  # sensors. 0 unless this zone/pump is the one /state currently reports as
  # active (the device only ever runs one thing at a time, so at most one of
  # these 12 is ever non-zero).
  #
  # Deliberately NOT re-synced from the device every tick: the device only
  # publishes /state on start/stop edges (see MqttService::publishState call
  # sites in main.ino), and polling it more often just to keep this number
  # fresh would mean extra MQTT traffic/device wake-ups for a number nobody
  # needs to the second. Instead each sensor free-runs locally: it takes the
  # `remaining_min` and `datetime` attributes from the *last* /state message
  # (the values at the moment the run started) and counts down from there
  # using HA's own clock - `elapsed_min` below. Referencing `now()` in the
  # template makes HA's template engine re-evaluate it once a minute on its
  # own (a built-in effect of any template that calls now()/utcnow() - see
  # helpers/template.py's time-tracking in HA core), so this ticks down
  # without any additional automation, MQTT traffic, or recorder writes
  # beyond one state change per minute while active. The two clocks (device
  # and HA) drifting apart over a run of up to ~120 min (see the manual-run
  # duration sliders) is not worth worrying about - see ha.md.
  #
  # The `+00:00` appended before `as_datetime` matters: formatIso8601Utc()
  # (CalendarMath.cpp) emits a bare "2026-07-12T06:00:00" with no zone
  # suffix even though the value is always UTC, so without forcing an
  # offset, `as_datetime` returns a naive datetime that can't be subtracted
  # from HA's tz-aware `now()`.
  - sensor:
      # Device-reported `uptime_s` (main.ino's `doc["uptime_s"] = nowMs / 1000UL`, an attribute
      # on sensor.irrigator_address_2's /status payload) is raw seconds - not friendly to read at
      # a glance for anything past a couple of hours. This reformats it as DD:HH:MM:SS (2 digits
      # each; days can't realistically exceed 2 digits since millis() itself wraps at ~49.7 days,
      # long before nowMs/1000UL would).
      - name: "Irrigator Uptime"
        unique_id: irrigator_uptime_formatted
        icon: mdi:clock-outline
        state: >-
          {% set s = state_attr('sensor.irrigator_address_2', 'uptime_s') | int(0) %}
          {{ '%02d:%02d:%02d:%02d' | format(s // 86400, (s % 86400) // 3600, (s % 3600) // 60, s % 60) }}
      - name: "Irrigator Pump Remaining"
        unique_id: irrigator_pump_remaining_sensor
        default_entity_id: sensor.irrigator_pump_remaining
        icon: mdi:timer-sand
        unit_of_measurement: min
        state: >-
          {% set active = state_attr('sensor.irrigator_watering_state', 'pump') | default(false) %}
          {% if active %}
            {% set started = (state_attr('sensor.irrigator_watering_state', 'datetime') ~ '+00:00') | as_datetime %}
            {% set elapsed_min = ((now() - started).total_seconds() / 60) | int(0) %}
            {{ [state_attr('sensor.irrigator_watering_state', 'remaining_min') | int(0) - elapsed_min, 0] | max }}
          {% else %}
            0
          {% endif %}
      - name: "Irrigator Zone 1 Remaining"
        unique_id: irrigator_zone_1_remaining_sensor
        default_entity_id: sensor.irrigator_zone_1_remaining
        icon: mdi:timer-sand
        unit_of_measurement: min
        state: >-
          {% set active = state_attr('sensor.irrigator_watering_state', 'zone') == 1 and (state_attr('sensor.irrigator_watering_state', 'on') | default(false)) %}
          {% if active %}
            {% set started = (state_attr('sensor.irrigator_watering_state', 'datetime') ~ '+00:00') | as_datetime %}
            {% set elapsed_min = ((now() - started).total_seconds() / 60) | int(0) %}
            {{ [state_attr('sensor.irrigator_watering_state', 'remaining_min') | int(0) - elapsed_min, 0] | max }}
          {% else %}
            0
          {% endif %}
      - name: "Irrigator Zone 2 Remaining"
        unique_id: irrigator_zone_2_remaining_sensor
        default_entity_id: sensor.irrigator_zone_2_remaining
        icon: mdi:timer-sand
        unit_of_measurement: min
        state: >-
          {% set active = state_attr('sensor.irrigator_watering_state', 'zone') == 2 and (state_attr('sensor.irrigator_watering_state', 'on') | default(false)) %}
          {% if active %}
            {% set started = (state_attr('sensor.irrigator_watering_state', 'datetime') ~ '+00:00') | as_datetime %}
            {% set elapsed_min = ((now() - started).total_seconds() / 60) | int(0) %}
            {{ [state_attr('sensor.irrigator_watering_state', 'remaining_min') | int(0) - elapsed_min, 0] | max }}
          {% else %}
            0
          {% endif %}
      - name: "Irrigator Zone 3 Remaining"
        unique_id: irrigator_zone_3_remaining_sensor
        default_entity_id: sensor.irrigator_zone_3_remaining
        icon: mdi:timer-sand
        unit_of_measurement: min
        state: >-
          {% set active = state_attr('sensor.irrigator_watering_state', 'zone') == 3 and (state_attr('sensor.irrigator_watering_state', 'on') | default(false)) %}
          {% if active %}
            {% set started = (state_attr('sensor.irrigator_watering_state', 'datetime') ~ '+00:00') | as_datetime %}
            {% set elapsed_min = ((now() - started).total_seconds() / 60) | int(0) %}
            {{ [state_attr('sensor.irrigator_watering_state', 'remaining_min') | int(0) - elapsed_min, 0] | max }}
          {% else %}
            0
          {% endif %}
      - name: "Irrigator Zone 4 Remaining"
        unique_id: irrigator_zone_4_remaining_sensor
        default_entity_id: sensor.irrigator_zone_4_remaining
        icon: mdi:timer-sand
        unit_of_measurement: min
        state: >-
          {% set active = state_attr('sensor.irrigator_watering_state', 'zone') == 4 and (state_attr('sensor.irrigator_watering_state', 'on') | default(false)) %}
          {% if active %}
            {% set started = (state_attr('sensor.irrigator_watering_state', 'datetime') ~ '+00:00') | as_datetime %}
            {% set elapsed_min = ((now() - started).total_seconds() / 60) | int(0) %}
            {{ [state_attr('sensor.irrigator_watering_state', 'remaining_min') | int(0) - elapsed_min, 0] | max }}
          {% else %}
            0
          {% endif %}
      - name: "Irrigator Zone 5 Remaining"
        unique_id: irrigator_zone_5_remaining_sensor
        default_entity_id: sensor.irrigator_zone_5_remaining
        icon: mdi:timer-sand
        unit_of_measurement: min
        state: >-
          {% set active = state_attr('sensor.irrigator_watering_state', 'zone') == 5 and (state_attr('sensor.irrigator_watering_state', 'on') | default(false)) %}
          {% if active %}
            {% set started = (state_attr('sensor.irrigator_watering_state', 'datetime') ~ '+00:00') | as_datetime %}
            {% set elapsed_min = ((now() - started).total_seconds() / 60) | int(0) %}
            {{ [state_attr('sensor.irrigator_watering_state', 'remaining_min') | int(0) - elapsed_min, 0] | max }}
          {% else %}
            0
          {% endif %}
      - name: "Irrigator Zone 6 Remaining"
        unique_id: irrigator_zone_6_remaining_sensor
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
          {% if active %}
            {% set started = (state_attr('sensor.irrigator_watering_state', 'datetime') ~ '+00:00') | as_datetime %}
            {% set elapsed_min = ((now() - started).total_seconds() / 60) | int(0) %}
            {{ [state_attr('sensor.irrigator_watering_state', 'remaining_min') | int(0) - elapsed_min, 0] | max }}
          {% else %}
            0
          {% endif %}

  # Offline command queue: any write the device might miss while
  # binary_sensor.irrigator_online is off gets appended here (via the
  # irrigator_queue_push event) instead of published straight away - see
  # script.irrigator_enqueue_or_publish, which is the only thing that ever
  # fires that event, and the "Irrigator - flush pending command queue"
  # automation below, which is the only thing that ever fires
  # irrigator_queue_pop. Self-accumulating trigger-based sensor: each firing
  # reads its own previous `items` attribute via `this.attributes.items`
  # (HA's standard accumulator pattern) and either appends one entry (push)
  # or drops the leading `count` entries once they've actually been
  # published (pop) - so a partial flush (device drops mid-batch) only pops
  # what really went out, leaving the rest for the next retry.
  - trigger:
      - trigger: event
        event_type: irrigator_queue_push
      - trigger: event
        event_type: irrigator_queue_pop
    sensor:
      - name: "Irrigator Command Queue"
        unique_id: irrigator_command_queue
        icon: mdi:playlist-clock
        unit_of_measurement: "items"
        state: >-
          {% set prev = this.attributes.items | default([]) %}
          {% if trigger.event.event_type == 'irrigator_queue_push' %}
            {{ (prev + [trigger.event.data]) | length }}
          {% else %}
            {{ (prev[trigger.event.data.count | default(0):]) | length }}
          {% endif %}
        attributes:
          items: >-
            {% set prev = this.attributes.items | default([]) %}
            {% if trigger.event.event_type == 'irrigator_queue_push' %}
              {{ prev + [{'topic': trigger.event.data.topic, 'payload': trigger.event.data.payload}] }}
            {% else %}
              {{ prev[trigger.event.data.count | default(0):] }}
            {% endif %}

  # Current schedule.json representation. Fed by two topics so it's always
  # up to date regardless of source: `.../schedule` (the device pushes this
  # on every change - HA upload, or the device's own rotary/display menu)
  # and `.../download/schedule.json` (the one-shot response to the
  # virgin-deploy request in irrigator_automations.yaml). Whichever arrives
  # last wins, which is exactly "update current schedule.json on arrival".
  # Its `records` attribute also feeds the "Device Schedule" table and the
  # schedule editor panel on the Schedule tab (see script.irrigator_schedule_save
  # / script.irrigator_schedule_delete and the "Irrigator - rebuild schedule
  # editor dropdown options" / "...load selected schedule record..."
  # automations in irrigator_automations.yaml).
  - trigger:
      - trigger: mqtt
        topic: "irrigatorF4/schedule"
      - trigger: mqtt
        topic: "irrigatorF4/download/schedule.json"
    sensor:
      - name: "Irrigator Schedule"
        unique_id: irrigator_schedule
        icon: mdi:calendar-sync
        state: "{{ trigger.payload_json | length }} records"
        attributes:
          records: "{{ trigger.payload_json }}"

  # Per-zone "liters used by the last completed run", feeding the diamonds on the Garden tab's
  # "Watering Timeline" chart. The device's /state message carries a run's total in `volume`
  # exactly once, on the message where that zone's `on` goes false (see MqttService::publishState
  # and FlowRunVolumeTracker) - so each sensor takes that value at the run's end and goes `unknown`
  # when its zone starts again. The reset on start is what makes every run a distinct recorded
  # state change, even two runs with an identical volume. Any other /state message leaves it as is.
  # volume 0 (no meter reading for the run) is ignored rather than plotted as a bogus 0 L run.
  - trigger:
      - trigger: mqtt
        topic: "irrigatorF4/state"
    sensor:
      - name: "Irrigator Zone 1 Run Volume"
        unique_id: irrigator_zone_1_run_volume
        icon: mdi:water-check
        unit_of_measurement: "L"
        device_class: water
        state: >-
          {% set p = trigger.payload_json %}
          {% if p.zone | int(-1) == 1 and p.on %}unknown
          {% elif p.zone | int(-1) == 1 and p.volume | float(0) > 0 %}{{ p.volume }}
          {% else %}{{ this.state }}{% endif %}
      - name: "Irrigator Zone 2 Run Volume"
        unique_id: irrigator_zone_2_run_volume
        icon: mdi:water-check
        unit_of_measurement: "L"
        device_class: water
        state: >-
          {% set p = trigger.payload_json %}
          {% if p.zone | int(-1) == 2 and p.on %}unknown
          {% elif p.zone | int(-1) == 2 and p.volume | float(0) > 0 %}{{ p.volume }}
          {% else %}{{ this.state }}{% endif %}
      - name: "Irrigator Zone 3 Run Volume"
        unique_id: irrigator_zone_3_run_volume
        icon: mdi:water-check
        unit_of_measurement: "L"
        device_class: water
        state: >-
          {% set p = trigger.payload_json %}
          {% if p.zone | int(-1) == 3 and p.on %}unknown
          {% elif p.zone | int(-1) == 3 and p.volume | float(0) > 0 %}{{ p.volume }}
          {% else %}{{ this.state }}{% endif %}
      - name: "Irrigator Zone 4 Run Volume"
        unique_id: irrigator_zone_4_run_volume
        icon: mdi:water-check
        unit_of_measurement: "L"
        device_class: water
        state: >-
          {% set p = trigger.payload_json %}
          {% if p.zone | int(-1) == 4 and p.on %}unknown
          {% elif p.zone | int(-1) == 4 and p.volume | float(0) > 0 %}{{ p.volume }}
          {% else %}{{ this.state }}{% endif %}
      - name: "Irrigator Zone 5 Run Volume"
        unique_id: irrigator_zone_5_run_volume
        icon: mdi:water-check
        unit_of_measurement: "L"
        device_class: water
        state: >-
          {% set p = trigger.payload_json %}
          {% if p.zone | int(-1) == 5 and p.on %}unknown
          {% elif p.zone | int(-1) == 5 and p.volume | float(0) > 0 %}{{ p.volume }}
          {% else %}{{ this.state }}{% endif %}
      - name: "Irrigator Zone 6 Run Volume"
        unique_id: irrigator_zone_6_run_volume
        icon: mdi:water-check
        unit_of_measurement: "L"
        device_class: water
        state: >-
          {% set p = trigger.payload_json %}
          {% if p.zone | int(-1) == 6 and p.on %}unknown
          {% elif p.zone | int(-1) == 6 and p.volume | float(0) > 0 %}{{ p.volume }}
          {% else %}{{ this.state }}{% endif %}
      - name: "Irrigator Zone 7 Run Volume"
        unique_id: irrigator_zone_7_run_volume
        icon: mdi:water-check
        unit_of_measurement: "L"
        device_class: water
        state: >-
          {% set p = trigger.payload_json %}
          {% if p.zone | int(-1) == 7 and p.on %}unknown
          {% elif p.zone | int(-1) == 7 and p.volume | float(0) > 0 %}{{ p.volume }}
          {% else %}{{ this.state }}{% endif %}
      - name: "Irrigator Zone 8 Run Volume"
        unique_id: irrigator_zone_8_run_volume
        icon: mdi:water-check
        unit_of_measurement: "L"
        device_class: water
        state: >-
          {% set p = trigger.payload_json %}
          {% if p.zone | int(-1) == 8 and p.on %}unknown
          {% elif p.zone | int(-1) == 8 and p.volume | float(0) > 0 %}{{ p.volume }}
          {% else %}{{ this.state }}{% endif %}
      - name: "Irrigator Zone 9 Run Volume"
        unique_id: irrigator_zone_9_run_volume
        icon: mdi:water-check
        unit_of_measurement: "L"
        device_class: water
        state: >-
          {% set p = trigger.payload_json %}
          {% if p.zone | int(-1) == 9 and p.on %}unknown
          {% elif p.zone | int(-1) == 9 and p.volume | float(0) > 0 %}{{ p.volume }}
          {% else %}{{ this.state }}{% endif %}
      - name: "Irrigator Zone 10 Run Volume"
        unique_id: irrigator_zone_10_run_volume
        icon: mdi:water-check
        unit_of_measurement: "L"
        device_class: water
        state: >-
          {% set p = trigger.payload_json %}
          {% if p.zone | int(-1) == 10 and p.on %}unknown
          {% elif p.zone | int(-1) == 10 and p.volume | float(0) > 0 %}{{ p.volume }}
          {% else %}{{ this.state }}{% endif %}
      - name: "Irrigator Zone 11 Run Volume"
        unique_id: irrigator_zone_11_run_volume
        icon: mdi:water-check
        unit_of_measurement: "L"
        device_class: water
        state: >-
          {% set p = trigger.payload_json %}
          {% if p.zone | int(-1) == 11 and p.on %}unknown
          {% elif p.zone | int(-1) == 11 and p.volume | float(0) > 0 %}{{ p.volume }}
          {% else %}{{ this.state }}{% endif %}

  # Persistent lifetime water per zone (+ "other"). The device's own per-zone counters
  # (irrigator_zone_N_water_total) are RAM-only and restart at 0 on every device reboot, so they are
  # really "since last boot". These accumulate the positive deltas of those counters in HA instead,
  # which survive device reboots (a drop is treated as a counter reset) and HA restarts (trigger
  # sensors restore their last state). Seeded from the counter's value the first time they run, so
  # history from before they existed can't be recovered - they count from creation onward.
  # An update where the previous value was unknown/unavailable adds nothing (no valid delta).
  - trigger:
      - trigger: state
        entity_id: sensor.irrigator_zone_1_water_total
      - trigger: state
        entity_id: sensor.irrigator_zone_2_water_total
      - trigger: state
        entity_id: sensor.irrigator_zone_3_water_total
      - trigger: state
        entity_id: sensor.irrigator_zone_4_water_total
      - trigger: state
        entity_id: sensor.irrigator_zone_5_water_total
      - trigger: state
        entity_id: sensor.irrigator_zone_6_water_total
      - trigger: state
        entity_id: sensor.irrigator_zone_7_water_total
      - trigger: state
        entity_id: sensor.irrigator_zone_8_water_total
      - trigger: state
        entity_id: sensor.irrigator_zone_9_water_total
      - trigger: state
        entity_id: sensor.irrigator_zone_10_water_total
      - trigger: state
        entity_id: sensor.irrigator_zone_11_water_total
      - trigger: state
        entity_id: sensor.irrigator_other_water_total
    sensor:
      - name: "Irrigator Zone 1 Water Lifetime"
        unique_id: irrigator_zone_1_water_lifetime
        icon: mdi:water-plus
        unit_of_measurement: "L"
        device_class: water
        state_class: total_increasing
        state: >-
          {% set cur = this.state | float(none) %}
          {% set new = trigger.to_state.state | float(none) %}
          {% set old = trigger.from_state.state | float(none) if trigger.from_state else none %}
          {% if trigger.entity_id != 'sensor.irrigator_zone_1_water_total' %}{{ this.state }}
          {% elif new is none %}{{ this.state }}
          {% elif cur is none %}{{ new | round(2) }}
          {% elif old is none %}{{ cur }}
          {% elif new >= old %}{{ (cur + new - old) | round(2) }}
          {% else %}{{ (cur + new) | round(2) }}{% endif %}
      - name: "Irrigator Zone 2 Water Lifetime"
        unique_id: irrigator_zone_2_water_lifetime
        icon: mdi:water-plus
        unit_of_measurement: "L"
        device_class: water
        state_class: total_increasing
        state: >-
          {% set cur = this.state | float(none) %}
          {% set new = trigger.to_state.state | float(none) %}
          {% set old = trigger.from_state.state | float(none) if trigger.from_state else none %}
          {% if trigger.entity_id != 'sensor.irrigator_zone_2_water_total' %}{{ this.state }}
          {% elif new is none %}{{ this.state }}
          {% elif cur is none %}{{ new | round(2) }}
          {% elif old is none %}{{ cur }}
          {% elif new >= old %}{{ (cur + new - old) | round(2) }}
          {% else %}{{ (cur + new) | round(2) }}{% endif %}
      - name: "Irrigator Zone 3 Water Lifetime"
        unique_id: irrigator_zone_3_water_lifetime
        icon: mdi:water-plus
        unit_of_measurement: "L"
        device_class: water
        state_class: total_increasing
        state: >-
          {% set cur = this.state | float(none) %}
          {% set new = trigger.to_state.state | float(none) %}
          {% set old = trigger.from_state.state | float(none) if trigger.from_state else none %}
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
          {% elif new is none %}{{ this.state }}
          {% elif cur is none %}{{ new | round(2) }}
          {% elif old is none %}{{ cur }}
          {% elif new >= old %}{{ (cur + new - old) | round(2) }}
          {% else %}{{ (cur + new) | round(2) }}{% endif %}
      - name: "Irrigator Zone 9 Water Lifetime"
        unique_id: irrigator_zone_9_water_lifetime
        icon: mdi:water-plus
        unit_of_measurement: "L"
        device_class: water
        state_class: total_increasing
        state: >-
          {% set cur = this.state | float(none) %}
          {% set new = trigger.to_state.state | float(none) %}
          {% set old = trigger.from_state.state | float(none) if trigger.from_state else none %}
          {% if trigger.entity_id != 'sensor.irrigator_zone_9_water_total' %}{{ this.state }}
          {% elif new is none %}{{ this.state }}
          {% elif cur is none %}{{ new | round(2) }}
          {% elif old is none %}{{ cur }}
          {% elif new >= old %}{{ (cur + new - old) | round(2) }}
          {% else %}{{ (cur + new) | round(2) }}{% endif %}
      - name: "Irrigator Zone 10 Water Lifetime"
        unique_id: irrigator_zone_10_water_lifetime
        icon: mdi:water-plus
        unit_of_measurement: "L"
        device_class: water
        state_class: total_increasing
        state: >-
          {% set cur = this.state | float(none) %}
          {% set new = trigger.to_state.state | float(none) %}
          {% set old = trigger.from_state.state | float(none) if trigger.from_state else none %}
          {% if trigger.entity_id != 'sensor.irrigator_zone_10_water_total' %}{{ this.state }}
          {% elif new is none %}{{ this.state }}
          {% elif cur is none %}{{ new | round(2) }}
          {% elif old is none %}{{ cur }}
          {% elif new >= old %}{{ (cur + new - old) | round(2) }}
          {% else %}{{ (cur + new) | round(2) }}{% endif %}
      - name: "Irrigator Zone 11 Water Lifetime"
        unique_id: irrigator_zone_11_water_lifetime
        icon: mdi:water-plus
        unit_of_measurement: "L"
        device_class: water
        state_class: total_increasing
        state: >-
          {% set cur = this.state | float(none) %}
          {% set new = trigger.to_state.state | float(none) %}
          {% set old = trigger.from_state.state | float(none) if trigger.from_state else none %}
          {% if trigger.entity_id != 'sensor.irrigator_zone_11_water_total' %}{{ this.state }}
          {% elif new is none %}{{ this.state }}
          {% elif cur is none %}{{ new | round(2) }}
          {% elif old is none %}{{ cur }}
          {% elif new >= old %}{{ (cur + new - old) | round(2) }}
          {% else %}{{ (cur + new) | round(2) }}{% endif %}
      - name: "Irrigator Other Water Lifetime"
        unique_id: irrigator_other_water_lifetime
        icon: mdi:water-plus
        unit_of_measurement: "L"
        device_class: water
        state_class: total_increasing
        state: >-
          {% set cur = this.state | float(none) %}
          {% set new = trigger.to_state.state | float(none) %}
          {% set old = trigger.from_state.state | float(none) if trigger.from_state else none %}
          {% if trigger.entity_id != 'sensor.irrigator_other_water_total' %}{{ this.state }}
          {% elif new is none %}{{ this.state }}
          {% elif cur is none %}{{ new | round(2) }}
          {% elif old is none %}{{ cur }}
          {% elif new >= old %}{{ (cur + new - old) | round(2) }}
          {% else %}{{ (cur + new) | round(2) }}{% endif %}

  # Weather-based auto-adjustment: read-only display of whatever
  # settings.json currently has - sourced straight from the same full-snapshot
  # sensor.irrigator_settings every other read-only field already uses, no new MQTT wiring needed.
  # NOTE: there is deliberately no "last update" equivalent here - that date is in-RAM only on the
  # device (never written to settings.json, see Settings.h), so HA has no way to know it; the
  # device's own rotary UI Settings menu is the only place it's shown.
  - sensor:
      - name: "Irrigator City"
        unique_id: irrigator_city
        icon: mdi:map-marker-outline
        state: "{{ (state_attr('sensor.irrigator_settings', 'Location') or {}).get('city') or '-' }}"
      - name: "Irrigator Coordinates"
        unique_id: irrigator_coordinates
        icon: mdi:crosshairs-gps
        state: >-
          {% set location = state_attr('sensor.irrigator_settings', 'Location') or {} %}
          {% if location.get('location_known') %}
            {{ '%.4f' | format(location.get('latitude', 0) | float(0)) }}, {{ '%.4f' | format(location.get('longitude', 0) | float(0)) }}
          {% else %}
            -
          {% endif %}
      # valve/pump_current_base_level live under settings.json's Current_sensor group (see
      # Settings.h), not as a top-level attribute of sensor.irrigator_settings - the stock
      # `entities` card's `type: attribute` row can only read a literal top-level attribute, and
      # has no `type: template` row (that's a full CARD type, not a row type - using it as a row
      # renders "Configuration error" in Lovelace). Same fix as City/Coordinates above: a small
      # derived sensor, referenced as a plain entity row in garden_tab.yaml.
      - name: "Irrigator Valve Base Level"
        unique_id: irrigator_valve_base_level
        icon: mdi:tune-variant
        state: >-
          {{ (state_attr('sensor.irrigator_settings', 'Current_sensor') or {}).get('valve_current_base_level', 0) }}
      - name: "Irrigator Pump Base Level"
        unique_id: irrigator_pump_base_level
        icon: mdi:tune-variant
        state: >-
          {{ (state_attr('sensor.irrigator_settings', 'Current_sensor') or {}).get('pump_current_base_level', 0) }}

      # "Last update date/time" row of the "Auto-adjustment by the Weather" card. `last_weather_update`
      # is a top-level key of the /status payload (main.ino's buildStatusJson), an ISO string in
      # naive UTC that the device omits entirely until its first successful weather fetch THIS
      # session - so this reads `unknown` after a device reboot until the next daily auto-adjustment
      # run lands. device_class: timestamp makes the entities-card row render it as relative age
      # ("2 hours ago") with the absolute time on hover; "+00:00" is appended so the tz-naive value
      # parses as the UTC instant it actually is (same trick as the pump-remaining sensors above).
      - name: "Irrigator Last Weather Update"
        unique_id: irrigator_last_weather_update
        device_class: timestamp
        icon: mdi:weather-partly-rainy
        state: >-
          {% set t = state_attr('sensor.irrigator_address_2', 'last_weather_update') %}
          {% if t %}{{ (t ~ '+00:00') | as_datetime }}{% endif %}

      # "Last decision" row of the "Auto-adjustment by the Weather" card. Per the two topics the
      # device publishes its auto-adjustment outcome on:
      #   - /skip_rain_until wins WHILE its timestamp is still in the future -> "Skip until <local>"
      #   - once that instant has passed (or no skip was ever issued) -> "Set to X%" from the
      #     retained /watering_percentage echo (sensor.irrigator_watering_percentage_echo).
      # now() in the template makes HA re-evaluate this once a minute, so it flips from the skip
      # text to the percentage text on its own the moment the skip window closes - no automation.
      - name: "Irrigator Last Decision"
        unique_id: irrigator_last_decision
        icon: mdi:scale-balance
        state: >-
          {% set skip = states('sensor.irrigator_rain_skip_until') %}
          {% set skip_dt = (skip ~ '+00:00') | as_datetime(none)
             if skip not in ['unknown', 'unavailable', 'none', '', none] else none %}
          {% if skip_dt is not none and skip_dt > now() %}
            Skip until {{ skip_dt | as_timestamp | timestamp_custom('%a %d %b %H:%M', true) }}
          {% else %}
            {% set pct = states('sensor.irrigator_watering_percentage_echo') %}
            {% if pct in ['unknown', 'unavailable', '', none] %}
              {% set pct = states('sensor.irrigator_settings') %}
            {% endif %}
            {% if pct in ['unknown', 'unavailable', '', none] %}
              Set to ?%
            {% else %}
              Set to {{ pct | int }}%
            {% endif %}
          {% endif %}

  - button:
      # Formerly "Irrigator Refresh From Device" - same entity (unique_id unchanged, so no
      # existing automation/dashboard reference to it breaks), renamed because it now does more
      # than refresh HA's live sensors: it also writes settings.json/schedule.json to
      # /config/irrigator_backups/ - see script.irrigator_backup_from_device's comment.
      - name: "Backup from the Irrigator Device"
        unique_id: irrigator_refresh_from_device
        icon: mdi:cloud-download-outline
        press:
          - action: script.irrigator_backup_from_device
      # Uploads the backup files the button above last wrote back to the device - see
      # script.irrigator_restore_from_backup's comment for exactly what is and isn't restored.
      # NOTE: this entity's entity_id is button.restore_to_the_irrigator_device (slugified from
      # `name:` below), NOT button.<unique_id> - `unique_id:` only pins the registry entry across
      # restarts for a template entity with no `device:` link like this one; it plays no part in
      # entity_id generation. Don't "fix" the dashboard/docs references back to
      # button.irrigator_restore_from_backup without also renaming this entity in the UI first.
      - name: "Restore to the Irrigator Device"
        unique_id: irrigator_restore_from_backup
        icon: mdi:cloud-upload-outline
        press:
          - action: script.irrigator_restore_from_backup
      - name: "Irrigator Save Schedule Record"
        unique_id: irrigator_schedule_save_button
        icon: mdi:content-save-outline
        press:
          - action: script.irrigator_schedule_save
      - name: "Irrigator Delete Schedule Record"
        unique_id: irrigator_schedule_delete_button
        icon: mdi:trash-can-outline
        press:
          - action: script.irrigator_schedule_delete
      - name: "Irrigator Test All"
        unique_id: irrigator_test_all_button
        icon: mdi:play-circle-outline
        press:
          - action: script.irrigator_test_all
      - name: "Irrigator Stop All"
        unique_id: irrigator_stop_all_button
        icon: mdi:stop-circle-outline
        press:
          - action: script.irrigator_stop_all
      # Requires an actual watering run (valve open, not just the pump alone) to be in progress -
      # the device rejects it with /alert otherwise (see sensor.irrigator_last_alert). See
      # docs/technical.md's "cmd/calibrate" section.
      - name: "Irrigator Calibrate"
        unique_id: irrigator_calibrate_button
        icon: mdi:tune-variant
        press:
          - action: script.irrigator_calibrate

# -----------------------------------------------------------------------
# Rolling 24h water consumption per zone (+ "other"), read by the "Water Consumption" table in
# garden_tab.yaml. A markdown card can't query long-term statistics, so these statistics-platform
# sensors compute the trailing-24h volume from the lifetime counters above.
# sum_differences_nonnegative treats a drop (device reboot resetting the RAM-only counter) as a
# reset instead of negative consumption. Caveat: the first sample inside the window only serves as
# a baseline, so a run that started just before the window edge is under-counted by its first step.
# -----------------------------------------------------------------------
sensor:
  - platform: statistics
    name: "Irrigator Zone 1 Water 24h"
    unique_id: irrigator_zone_1_water_24h
    entity_id: sensor.irrigator_zone_1_water_total
    state_characteristic: sum_differences_nonnegative
    max_age:
      hours: 24
    sampling_size: 1000
  - platform: statistics
    name: "Irrigator Zone 2 Water 24h"
    unique_id: irrigator_zone_2_water_24h
    entity_id: sensor.irrigator_zone_2_water_total
    state_characteristic: sum_differences_nonnegative
    max_age:
      hours: 24
    sampling_size: 1000
  - platform: statistics
    name: "Irrigator Zone 3 Water 24h"
    unique_id: irrigator_zone_3_water_24h
    entity_id: sensor.irrigator_zone_3_water_total
    state_characteristic: sum_differences_nonnegative
    max_age:
      hours: 24
    sampling_size: 1000
  - platform: statistics
    name: "Irrigator Zone 4 Water 24h"
    unique_id: irrigator_zone_4_water_24h
    entity_id: sensor.irrigator_zone_4_water_total
    state_characteristic: sum_differences_nonnegative
    max_age:
      hours: 24
    sampling_size: 1000
  - platform: statistics
    name: "Irrigator Zone 5 Water 24h"
    unique_id: irrigator_zone_5_water_24h
    entity_id: sensor.irrigator_zone_5_water_total
    state_characteristic: sum_differences_nonnegative
    max_age:
      hours: 24
    sampling_size: 1000
  - platform: statistics
    name: "Irrigator Zone 6 Water 24h"
    unique_id: irrigator_zone_6_water_24h
    entity_id: sensor.irrigator_zone_6_water_total
    state_characteristic: sum_differences_nonnegative
    max_age:
      hours: 24
    sampling_size: 1000
  - platform: statistics
    name: "Irrigator Zone 7 Water 24h"
    unique_id: irrigator_zone_7_water_24h
    entity_id: sensor.irrigator_zone_7_water_total
    state_characteristic: sum_differences_nonnegative
    max_age:
      hours: 24
    sampling_size: 1000
  - platform: statistics
    name: "Irrigator Zone 8 Water 24h"
    unique_id: irrigator_zone_8_water_24h
    entity_id: sensor.irrigator_zone_8_water_total
    state_characteristic: sum_differences_nonnegative
    max_age:
      hours: 24
    sampling_size: 1000
  - platform: statistics
    name: "Irrigator Zone 9 Water 24h"
    unique_id: irrigator_zone_9_water_24h
    entity_id: sensor.irrigator_zone_9_water_total
    state_characteristic: sum_differences_nonnegative
    max_age:
      hours: 24
    sampling_size: 1000
  - platform: statistics
    name: "Irrigator Zone 10 Water 24h"
    unique_id: irrigator_zone_10_water_24h
    entity_id: sensor.irrigator_zone_10_water_total
    state_characteristic: sum_differences_nonnegative
    max_age:
      hours: 24
    sampling_size: 1000
  - platform: statistics
    name: "Irrigator Zone 11 Water 24h"
    unique_id: irrigator_zone_11_water_24h
    entity_id: sensor.irrigator_zone_11_water_total
    state_characteristic: sum_differences_nonnegative
    max_age:
      hours: 24
    sampling_size: 1000
  - platform: statistics
    name: "Irrigator Other Water 24h"
    unique_id: irrigator_other_water_24h
    entity_id: sensor.irrigator_other_water_total
    state_characteristic: sum_differences_nonnegative
    max_age:
      hours: 24
    sampling_size: 1000

# -----------------------------------------------------------------------
# Keep the per-minute countdown sensors (template block above) out of the recorder database: they
# only change while a run is active, are derived from sensor.irrigator_watering_state (which is
# recorded), and have no value as history. Excluding them skips both state rows and statistics.
# Existing rows are purged with the recorder.purge_entities action (entity_globs below).
# Do not also define `recorder:` in configuration.yaml - merge these keys there instead.
# -----------------------------------------------------------------------
recorder:
  exclude:
    entity_globs:
      - sensor.irrigator_zone_*_remaining
      - sensor.irrigator_pump_remaining

# -----------------------------------------------------------------------
# Manual-run duration sliders (1-120 min), one per pump/zone card.
# -----------------------------------------------------------------------
input_number:
  irrigator_pump_duration:
    name: "Pump Duration"
    icon: mdi:timer-outline
    min: 1
    max: 120
    step: 1
    mode: box
    unit_of_measurement: min
    initial: 5
  irrigator_zone_1_duration: &zone_duration_helper
    name: "Duration"
    icon: mdi:timer-outline
    min: 1
    max: 120
    step: 1
    mode: box
    unit_of_measurement: min
    initial: 5
  irrigator_zone_2_duration: *zone_duration_helper
  irrigator_zone_3_duration: *zone_duration_helper
  irrigator_zone_4_duration: *zone_duration_helper
  irrigator_zone_5_duration: *zone_duration_helper
  irrigator_zone_6_duration: *zone_duration_helper
  irrigator_zone_7_duration: *zone_duration_helper
  irrigator_zone_8_duration: *zone_duration_helper
  irrigator_zone_9_duration: *zone_duration_helper
  irrigator_zone_10_duration: *zone_duration_helper
  irrigator_zone_11_duration: *zone_duration_helper

  # Settings tab: default_manual_duration (1-60 per ha.md) + current-sensor
  # calibration. All of these go out via the full-settings republish script
  # (script.irrigator_publish_settings) - see irrigator_automations.yaml.
  irrigator_default_manual_duration:
    name: "Default Manual Duration"
    icon: mdi:timer-cog-outline
    min: 1
    max: 60
    step: 1
    mode: slider
    unit_of_measurement: min
    initial: 5

  # Garden tab: manual watering_percentage override. Used to be a template
  # `number:` entity that published straight to cmd/watering_percentage on
  # every set_value - which meant an unrelated full-settings republish
  # (triggered by, say, a zone name edit) could race a momentary echo-sensor
  # dropout and silently stomp the device's real percentage back to 100 (see
  # the "Irrigator: republish full settings.json" comment in
  # irrigator_automations.yaml for the mechanics of that class of bug). Now a
  # plain input_number like every other settings.json field: seeded from the
  # device on every settings.json download ("Irrigator - sync device settings
  # to local helpers"), and any user edit goes out via the SAME full-settings
  # republish as the other 15 fields ("Irrigator - republish settings on
  # local helper change") - both guarded by input_boolean.irrigator_syncing_from_device
  # so a value just received from the device is never bounced straight back.
  # Trade-off: unlike the old echo-sourced entity, this does NOT live-update
  # when the device's own weather-driven auto-adjustment changes
  # wateringPercentage on its own (main.ino's AutoAdjustment calls) - it only
  # picks that up on the next settings.json (re)download. Still visible live
  # in the meantime via sensor.irrigator_watering_percentage_echo (the
  # /watering_percentage echo sensor), which is unaffected by this change.
  irrigator_watering_percentage:
    name: "Watering Percentage"
    icon: mdi:water-percent
    min: 0
    max: 300
    step: 5
    mode: box
    unit_of_measurement: "%"
    initial: 100

  # Auto-adjustment clamp bounds - the only two auto-adjustment fields
  # editable from HA (per Phase 5); everything else in that feature is read-only, see the
  # template sensors above.
  irrigator_upper_limit:
    name: "Auto-Adjustment Upper Limit"
    icon: mdi:water-plus-outline
    min: 0
    max: 500
    step: 5
    mode: box
    unit_of_measurement: "%"
    initial: 200
  irrigator_lower_limit:
    name: "Auto-Adjustment Lower Limit"
    icon: mdi:water-minus-outline
    min: 0
    max: 500
    step: 5
    mode: box
    unit_of_measurement: "%"
    initial: 40

  # Step 1's forecast-rain threshold - also user-configurable from HA (see
  # domain::effectiveRainMm): a forecast at/over this probability (>=) is counted as
  # already-fallen rain, in full, in the percentage formula.
  irrigator_rain_forecast_probability:
    name: "Forecast Rain Probability Threshold"
    icon: mdi:weather-pouring
    min: 0
    max: 100
    step: 5
    mode: box
    unit_of_measurement: "%"
    initial: 70

  # Flow-meter anomaly-check threshold (settings.json's FlowMeter.expected_flow_rate_lpm) - the
  # steady-state flow rate expected while a zone is watering, compared against live readings
  # (±50%, flow_high/flow_low faults - see docs/technical.md's "Water flow sensing (TUF-2000M)"
  # section). 0 = not configured, no check runs. A good starting value is the flow_rate_lpm
  # that cmd/meter reports during a normal run.
  irrigator_expected_flow_rate_lpm:
    name: "Expected Flow Rate"
    icon: mdi:water-pump
    min: 0
    max: 500
    step: 1
    mode: box
    unit_of_measurement: "L/min"
    initial: 0

  # Schedule editor panel field (Schedule tab) - see script.irrigator_schedule_save.
  irrigator_edit_duration_min:
    name: "Duration"
    icon: mdi:timer-outline
    min: 1
    max: 60
    step: 1
    mode: slider
    unit_of_measurement: min
    initial: 5

# -----------------------------------------------------------------------
# Schedule tab: record picker + edit fields, replacing the earlier Local
# Calendar design (calendar.create_event has no `rrule` field - true
# recurrence is a frontend-only capability of the calendar dialog, not
# something a script can set - so an automation-driven calendar could only
# ever have been a partial solution; this editor works directly against
# schedule.json's records instead, no calendar entities involved).
#
# irrigator_schedule_picker's options are rebuilt on every schedule/settings
# change (see "Irrigator - rebuild schedule editor dropdown options" in
# irrigator_automations.yaml), one per current record plus "+ Add new",
# formatted "[<index>] Zone <n> - <name> - <day> <time> - <dur>min" - the
# leading "[<index>]" is the record's position in sensor.irrigator_schedule's
# `records` list (also shown as the "#" column in the "Device Schedule"
# table below, regardless of how that table is currently sorted), which is
# how script.irrigator_schedule_save/_delete know which record to touch.
# irrigator_edit_zone's options are rebuilt the same way, formatted
# "<n> - <name>".
# -----------------------------------------------------------------------
input_select:
  irrigator_schedule_picker:
    name: "Schedule Record"
    icon: mdi:calendar-search
    options: ["+ Add new"]
    initial: "+ Add new"

  irrigator_edit_zone:
    name: "Zone"
    icon: mdi:sprinkler-variant
    options: ["1 - #1 (no name)"]
    initial: "1 - #1 (no name)"

  irrigator_edit_day:
    name: "Day"
    icon: mdi:calendar-week
    options: ["Mon", "Tue", "Wed", "Thu", "Fri", "Sat", "Sun"]
    initial: "Mon"

  # Purely a display-order control for the "Device Schedule" markdown table
  # (see garden_tab.yaml) - a stock markdown card can't run JS, so a real
  # click-the-column-header sort isn't possible; this dropdown is the native
  # equivalent. Doesn't touch the device or any helper.
  irrigator_schedule_sort_by:
    name: "Sort Schedule Table By"
    icon: mdi:sort
    options: ["Day", "Zone", "Name", "Start", "Duration", "Active"]
    initial: "Day"

input_datetime:
  # Schedule editor panel field (Schedule tab) - see script.irrigator_schedule_save.
  irrigator_edit_start_time:
    name: "Start Time"
    icon: mdi:clock-outline
    has_date: false
    has_time: true

# -----------------------------------------------------------------------
# Settings tab: editable zone name + enabled checkbox. Both lack a
# dedicated device-side merge topic, so any change here republishes the
# FULL settings.json (see script.irrigator_publish_settings) - the
# firmware's cmd/upload/settings.json replaces the whole object and fills
# missing fields with factory defaults, so a partial payload would silently
# reset everything else. `initial:` here is only what's shown before the
# first device sync ever completes - "Irrigator - sync device settings to
# local helpers" (irrigator_automations.yaml) overwrites it with the real
# name/flag from the device the moment sensor.irrigator_settings gets data.
# -----------------------------------------------------------------------
input_text:
  irrigator_zone_1_name: {name: "Zone 1 Name", icon: mdi:label-outline, max: 15, initial: "#1 (no name)"}
  irrigator_zone_2_name: {name: "Zone 2 Name", icon: mdi:label-outline, max: 15, initial: "#2 (no name)"}
  irrigator_zone_3_name: {name: "Zone 3 Name", icon: mdi:label-outline, max: 15, initial: "#3 (no name)"}
  irrigator_zone_4_name: {name: "Zone 4 Name", icon: mdi:label-outline, max: 15, initial: "#4 (no name)"}
  irrigator_zone_5_name: {name: "Zone 5 Name", icon: mdi:label-outline, max: 15, initial: "#5 (no name)"}
  irrigator_zone_6_name: {name: "Zone 6 Name", icon: mdi:label-outline, max: 15, initial: "#6 (no name)"}
  irrigator_zone_7_name: {name: "Zone 7 Name", icon: mdi:label-outline, max: 15, initial: "#7 (no name)"}
  irrigator_zone_8_name: {name: "Zone 8 Name", icon: mdi:label-outline, max: 15, initial: "#8 (no name)"}
  irrigator_zone_9_name: {name: "Zone 9 Name", icon: mdi:label-outline, max: 15, initial: "#9 (no name)"}
  irrigator_zone_10_name: {name: "Zone 10 Name", icon: mdi:label-outline, max: 15, initial: "#10 (no name)"}
  irrigator_zone_11_name: {name: "Zone 11 Name", icon: mdi:label-outline, max: 15, initial: "#11 (no name)"}

  # WeatherAPI.com fallback key (Settings::weatherApiKey) - only ever used when Open-Meteo's
  # keyless call fails. mode: password just masks the dashboard tile; the key is still visible in
  # plaintext via sensor.irrigator_settings' attributes below (see the comment on that field in
  # Settings.h) - there's no way to selectively exclude one attribute from that sensor without
  # reworking it entirely, so this isn't a real secret store, just a convenience field.
  irrigator_weatherapi_key: {name: "WeatherAPI.com Key", icon: mdi:key-outline, max: 47, mode: password, initial: ""}

input_boolean:
  # Schedule editor panel field (Schedule tab) - see script.irrigator_schedule_save.
  irrigator_edit_active:
    name: "Active"
    icon: mdi:check-circle-outline
    initial: true

  # Internal guard, not on any dashboard - see the "Irrigator - sync device
  # settings to local helpers" / "Irrigator - republish settings on local
  # helper change" automations in irrigator_automations.yaml for what it
  # prevents (a boot-time race that re-uploads stale settings to the device).
  irrigator_syncing_from_device:
    name: "Irrigator Syncing From Device"
    icon: mdi:sync

  irrigator_zone_1_enabled: {name: "Zone 1 Enabled", icon: mdi:check-circle-outline}
  irrigator_zone_2_enabled: {name: "Zone 2 Enabled", icon: mdi:check-circle-outline}
  irrigator_zone_3_enabled: {name: "Zone 3 Enabled", icon: mdi:check-circle-outline}
  irrigator_zone_4_enabled: {name: "Zone 4 Enabled", icon: mdi:check-circle-outline}
  irrigator_zone_5_enabled: {name: "Zone 5 Enabled", icon: mdi:check-circle-outline}
  irrigator_zone_6_enabled: {name: "Zone 6 Enabled", icon: mdi:check-circle-outline}
  irrigator_zone_7_enabled: {name: "Zone 7 Enabled", icon: mdi:check-circle-outline}
  irrigator_zone_8_enabled: {name: "Zone 8 Enabled", icon: mdi:check-circle-outline}
  irrigator_zone_9_enabled: {name: "Zone 9 Enabled", icon: mdi:check-circle-outline}
  irrigator_zone_10_enabled: {name: "Zone 10 Enabled", icon: mdi:check-circle-outline}
  irrigator_zone_11_enabled: {name: "Zone 11 Enabled", icon: mdi:check-circle-outline}

  # Current-fault alert toggles - settings.json's Current_sensor group (Settings::alertPumpUc/
  # alertPumpOc/alertValveUc/alertValveOc). Only meaningful once the corresponding sensor has been
  # calibrated (see "Current-Sensor Calibration" card in garden_tab.yaml) - the firmware skips the
  # underlying check entirely while base level is 0, regardless of these toggles. Default true,
  # same as the firmware's own default for a settings.json that's never set them.
  irrigator_alert_pump_uc: {name: "Alert Pump Under-current", icon: mdi:alert-circle-outline, initial: true}
  irrigator_alert_pump_oc: {name: "Alert Pump Over-current", icon: mdi:alert-circle-outline, initial: true}
  irrigator_alert_valve_uc: {name: "Alert Valve Under-current", icon: mdi:alert-circle-outline, initial: true}
  irrigator_alert_valve_oc: {name: "Alert Valve Over-current", icon: mdi:alert-circle-outline, initial: true}

  # Flow-meter feature master toggle (settings.json's FlowMeter.flow_meter_enabled) - gates the
  # flow-rate anomaly check specifically (main.ino). Does NOT stop the underlying Modbus polling or
  # the raw /flow telemetry/consumption sensors above, which run unconditionally. Default true,
  # same as every other alert-style toggle here.
  irrigator_flow_meter_enabled: {name: "Flow Meter Enabled", icon: mdi:water-pump, initial: true}

# -----------------------------------------------------------------------
# Backup/restore file plumbing for script.irrigator_backup_from_device /
# script.irrigator_restore_from_backup below (see `script:`'s comment on
# each). Both settings.json and schedule.json land under
# /config/irrigator_backups/ - "latest" is what Restore always reads;
# the timestamped copy alongside it is a manually-browsable history
# (Studio Code Server / File editor / Samba add-on), never read by
# anything here. `/config` is Home Assistant's own config directory,
# reachable identically on HA OS, Supervised, and Docker installs.
#
# Content NEVER touches a shell command string in either direction:
#   - Write: `command_line: notify:` pipes its `message` field to the
#     command's STDIN (confirmed against home-assistant/core's
#     command_line/notify.py - `proc.communicate(input=message)`), so a
#     zone name with a quote, `$`, or backtick in it is inert - it's
#     just bytes on a pipe, never re-parsed as shell syntax. The command
#     itself is 100% static (no `{{ }}`), so it isn't subject to
#     `shell_command`'s "no `>`/`|`/`~`" template restriction either.
#   - Read: `shell_command:` below is also fully static (no `{{ }}`), so
#     it takes the same real-shell path and its output is returned via
#     `response_variable` (`{{ result.stdout }}`) as a plain script
#     variable - no entity `state:` involved, so the ~255-char HA state
#     length limit that a sensor would hit on a multi-KB settings.json
#     never applies.
# Deliberately NOT a templated command with a per-call filename (e.g. one
# shared notify parameterized by "settings"/"schedule") - `command_line:
# notify:` always runs via a real shell even when templated (unlike
# shell_command's safer exec-when-templated mode), so keeping these fully
# static keeps the whole read/write path free of any injection surface
# to reason about, for a handful of near-identical lines' cost.
command_line:
  - notify:
      name: irrigator_backup_write_settings
      command: >-
        mkdir -p /config/irrigator_backups &&
        ts=$(date +%Y%m%d_%H%M%S) &&
        tee "/config/irrigator_backups/settings_$ts.json" > "/config/irrigator_backups/settings_latest.json"
  - notify:
      name: irrigator_backup_write_schedule
      command: >-
        mkdir -p /config/irrigator_backups &&
        ts=$(date +%Y%m%d_%H%M%S) &&
        tee "/config/irrigator_backups/schedule_$ts.json" > "/config/irrigator_backups/schedule_latest.json"

shell_command:
  # `cat` on a missing file exits non-zero with empty stdout - that's the
  # "no backup taken yet" signal script.irrigator_restore_from_backup checks
  # for via response_variable.returncode, not a failure worth surfacing as
  # a distinct error path.
  irrigator_backup_read_settings: "cat /config/irrigator_backups/settings_latest.json 2>/dev/null"
  irrigator_backup_read_schedule: "cat /config/irrigator_backups/schedule_latest.json 2>/dev/null"

# -----------------------------------------------------------------------
# Scripts - all device writes funnel through these so the JSON contract
# (see src/network/MqttService.cpp / src/main.ino handleMqttCommand) is
# built in exactly one place each.
# -----------------------------------------------------------------------
script:
  # Chokepoint for every device-bound MQTT write below (run/stop/test/settings/
  # schedule) - publishes immediately when the device is known online (today's
  # behavior, unchanged latency), otherwise appends {topic, payload} to
  # sensor.irrigator_command_queue via irrigator_queue_push for the
  # "Irrigator - flush pending command queue" automation to retry later.
  # binary_sensor.irrigator_online is the only online/offline signal that
  # exists (retained LWT topic) - there is no per-command device
  # acknowledgement for run/stop/scheduled/watering_percentage, so "published
  # while online" is the best available definition of success here.
  irrigator_enqueue_or_publish:
    alias: "Irrigator: publish now if online, else queue for retry"
    fields:
      topic:
        selector:
          text:
      payload:
        selector:
          text:
    sequence:
      - choose:
          - conditions:
              - condition: state
                entity_id: binary_sensor.irrigator_online
                state: "on"
            sequence:
              - action: mqtt.publish
                data:
                  topic: "{{ topic }}"
                  payload: "{{ payload }}"
        default:
          - event: irrigator_queue_push
            event_data:
              topic: "{{ topic }}"
              payload: "{{ payload }}"

  irrigator_start:
    alias: "Irrigator: start zone or pump"
    fields:
      zone:
        selector:
          number: {min: 0, max: 11, step: 1}
      duration:
        selector:
          number: {min: 1, max: 120, step: 1}
    sequence:
      - action: script.irrigator_enqueue_or_publish
        data:
          topic: "irrigatorF4/cmd/run"
          payload: "{{ {'zone': zone, 'duration': duration} | tojson }}"

  irrigator_stop:
    alias: "Irrigator: stop current watering"
    sequence:
      - action: script.irrigator_enqueue_or_publish
        data:
          topic: "irrigatorF4/cmd/stop"
          payload: ""

  irrigator_stop_all:
    alias: "Irrigator: stop and clear queue"
    sequence:
      - action: script.irrigator_enqueue_or_publish
        data:
          topic: "irrigatorF4/cmd/stop"
          payload: "all"

  # Queues a short manual run on every zone the settings.json zone_names map
  # marks enabled (same "enabled" flag the binary_sensor.irrigator_zone_N_enabled_sensor
  # entities above read) - a quick way to confirm all real zones are wired up
  # without opening each switch by hand. The device itself serializes these
  # (see queue/state topics), so publishing all of them back-to-back just
  # fills the queue rather than running zones concurrently.
  irrigator_test_all:
    alias: "Irrigator: test all active zones"
    sequence:
      - variables:
          duration: "{{ states('input_number.irrigator_default_manual_duration') | int(5) }}"
      - repeat:
          for_each: "{{ range(1, 12) | list }}"
          sequence:
            - if:
                - condition: template
                  value_template: >-
                    {{ (state_attr('sensor.irrigator_settings', 'Zones') or {}).get(repeat.item | string, {}).get('enabled', true) }}
              then:
                - action: script.irrigator_enqueue_or_publish
                  data:
                    topic: "irrigatorF4/cmd/run"
                    payload: "{{ {'zone': repeat.item, 'duration': duration} | tojson }}"

  irrigator_calibrate:
    alias: "Irrigator: capture current-sensor calibration base"
    sequence:
      - action: script.irrigator_enqueue_or_publish
        data:
          topic: "irrigatorF4/cmd/calibrate"
          payload: ""

  # Behind button.irrigator_refresh_from_device ("Backup from the Irrigator Device" - see
  # irrigator.yaml's `button:` block). Formerly just fire-and-forget cmd/download requests
  # (sensor.irrigator_settings/irrigator_schedule picked up whatever arrived, same as any other
  # download); now also waits for each response and writes it verbatim to
  # /config/irrigator_backups/ (see the command_line:/shell_command: block above) so there's an
  # actual recoverable file on the HA filesystem, not just live entity state that's gone the moment
  # a later download overwrites it. `trigger.payload` (not `payload_json`) is used for the write so
  # the backup is byte-identical to what the device sent - it is never reparsed/re-serialized
  # through Jinja's `tojson`, which could reorder keys or reformat numbers.
  #
  # Two independent wait_for_trigger/write pairs, not one combined wait: settings.json and
  # schedule.json arrive as two separate MQTT messages with no guaranteed order, and a device that
  # answers one but not the other (e.g. it reboots mid-response) should still back up whichever one
  # it did answer, rather than an all-or-nothing failure discarding a response that did arrive.
  irrigator_backup_from_device:
    alias: "Irrigator: backup settings.json + schedule.json from device to HA filesystem"
    sequence:
      - action: mqtt.publish
        data: {topic: "irrigatorF4/cmd/status", payload: ""}
      - action: mqtt.publish
        data: {topic: "irrigatorF4/cmd/download/settings.json", payload: ""}
      - wait_for_trigger:
          - trigger: mqtt
            topic: "irrigatorF4/download/settings.json"
        timeout:
          seconds: 15
        continue_on_timeout: true
      - if:
          - condition: template
            value_template: "{{ wait.completed }}"
        then:
          - action: notify.irrigator_backup_write_settings
            data:
              message: "{{ wait.trigger.payload }}"
        else:
          - action: persistent_notification.create
            data:
              title: "Irrigator backup: settings.json"
              message: >-
                No response from the device within 15s - is it online? Nothing was written; the
                previous backup (if any) under /config/irrigator_backups/ is untouched.
      - action: mqtt.publish
        data: {topic: "irrigatorF4/cmd/download/schedule.json", payload: ""}
      - wait_for_trigger:
          - trigger: mqtt
            topic: "irrigatorF4/download/schedule.json"
        timeout:
          seconds: 15
        continue_on_timeout: true
      - if:
          - condition: template
            value_template: "{{ wait.completed }}"
        then:
          - action: notify.irrigator_backup_write_schedule
            data:
              message: "{{ wait.trigger.payload }}"
        else:
          - action: persistent_notification.create
            data:
              title: "Irrigator backup: schedule.json"
              message: >-
                No response from the device within 15s - is it online? Nothing was written; the
                previous backup (if any) under /config/irrigator_backups/ is untouched.

  # Behind button.restore_to_the_irrigator_device ("Restore to the Irrigator Device" - the
  # entity_id comes from slugifying `name:` at first creation, NOT from `unique_id:` below
  # (unique_id only pins the registry entry across restarts for an un-device-linked template
  # entity like this one) - see
  # irrigator.yaml's `button:` block): uploads the LAST files script.irrigator_backup_from_device
  # wrote under /config/irrigator_backups/ back to the device, verbatim - not a reconstruction from
  # the Settings-tab helpers (that's script.irrigator_publish_settings's job, and it can only ever
  # cover the fields those helpers expose). Routed through script.irrigator_enqueue_or_publish, same
  # as every other device-bound write, so a restore requested while the device is briefly offline is
  # queued and retried rather than silently dropped.
  #
  # settings.json's device-owned fields (schedule_active, the two current-sensor calibration bases -
  # see script.irrigator_publish_settings' comment) are safe to restore from a stale backup: the
  # firmware overwrites whatever an upload carries for them with its own current values before
  # persisting (see mergeSettings() in Settings.h), so this can never revert a calibration or flip
  # the schedule on/off as a side effect.
  #
  # Deliberately does NOT auto-refresh sensor.irrigator_settings/irrigator_schedule afterward by
  # re-running the backup script: if the device was offline and the upload only got queued (not
  # actually delivered yet), an immediate re-backup would capture the device's OLD content and
  # silently overwrite the very backup file this restore just read from. Press "Backup from the
  # Irrigator Device" afterward to confirm the restore actually landed.
  irrigator_restore_from_backup:
    alias: "Irrigator: restore settings.json + schedule.json from HA filesystem backup to device"
    sequence:
      - action: shell_command.irrigator_backup_read_settings
        response_variable: irrigator_settings_backup
      - action: shell_command.irrigator_backup_read_schedule
        response_variable: irrigator_schedule_backup
      - if:
          - condition: template
            value_template: >-
              {{ irrigator_settings_backup.returncode == 0 and
                 (irrigator_settings_backup.stdout | trim | length) > 0 }}
        then:
          - action: script.irrigator_enqueue_or_publish
            data:
              topic: "irrigatorF4/cmd/upload/settings.json"
              payload: "{{ irrigator_settings_backup.stdout }}"
        else:
          - action: persistent_notification.create
            data:
              title: "Irrigator restore: settings.json"
              message: >-
                No backup found under /config/irrigator_backups/ - press "Backup from the Irrigator
                Device" at least once first.
      - if:
          - condition: template
            value_template: >-
              {{ irrigator_schedule_backup.returncode == 0 and
                 (irrigator_schedule_backup.stdout | trim | length) > 0 }}
        then:
          - action: script.irrigator_enqueue_or_publish
            data:
              topic: "irrigatorF4/cmd/upload/schedule.json"
              payload: "{{ irrigator_schedule_backup.stdout }}"
        else:
          - action: persistent_notification.create
            data:
              title: "Irrigator restore: schedule.json"
              message: >-
                No backup found under /config/irrigator_backups/ - press "Backup from the Irrigator
                Device" at least once first.

  # Full settings.json replace. Must include every field every time - the
  # firmware fills anything missing with factory defaults (parseSettings()),
  # it does not merge against what's currently on flash. This is the ONLY
  # settings-writing script.
  #
  # settings.json is nested into 4 groups (Zones/Location/Current_sensor/Watering - see
  # Settings.h). watering_percentage is read from input_number.irrigator_watering_percentage
  # (a plain local helper, same as default_manual_duration below) rather than from any device
  # echo - see that helper's comment in `input_number:` above for why.
  #
  # Watering.schedule_active and Current_sensor.valve/pump_current_base_level are device-owned
  # fields: the FIRMWARE ignores whatever a settings upload carries for them (schedule_active is
  # changed only via cmd/scheduled; the two current bases only via cmd/calibrate - see
  # mergeSettings()'s doc in Settings.h and handleMqttUpload's SETTINGS_FILE_PATH branch in
  # main.ino, which overwrites all three with the device's own current values before persisting).
  # So the values sent here are cosmetic - they cannot change the device. They're still included,
  # sourced from sensor.irrigator_settings' own last-downloaded attributes, purely so the JSON
  # stays a faithful full snapshot; schedule_active specifically is deliberately NOT read from
  # switch.irrigator_schedule_active (whose echo sensor reads a spurious `false` while
  # `unavailable` during a reconnect - the exact stale value that used to get uploaded and disable
  # the schedule before the firmware started ignoring it).
  #
  # watering_percentage, the 4 Current_sensor.alert_* toggles, and both FlowMeter fields are NOT
  # device-owned in the same way - they're plain input_number/input_boolean helpers the user edits
  # (see their comments in `input_number:`/`input_boolean:` above), read directly, and the firmware
  # DOES apply them from an upload.
  irrigator_publish_settings:
    alias: "Irrigator: republish full settings.json"
    sequence:
      - variables:
          zn: >-
            {% set ns = namespace(parts=[]) %}
            {% for z in range(1, 12) %}
              {% set nm = states('input_text.irrigator_zone_' ~ z ~ '_name') | tojson %}
              {% set en = is_state('input_boolean.irrigator_zone_' ~ z ~ '_enabled', 'on') | tojson %}
              {% set ns.parts = ns.parts + ['"' ~ z ~ '":{"name":' ~ nm ~ ',"enabled":' ~ en ~ '}'] %}
            {% endfor %}
            {{ '{' ~ (ns.parts | join(',')) ~ '}' }}
          existing_watering: "{{ state_attr('sensor.irrigator_settings', 'Watering') or {} }}"
          existing_location: "{{ state_attr('sensor.irrigator_settings', 'Location') or {} }}"
          existing_current_sensor: "{{ state_attr('sensor.irrigator_settings', 'Current_sensor') or {} }}"
      # zn is already a JSON-object string, not a Python dict, so it can't be embedded via the
      # dict-literal-then-tojson pattern used for the other groups (that would double-encode it as
      # a quoted string). Instead the dict of the other 3 groups is rendered with tojson, then its
      # closing brace is sliced off and the "Zones" group spliced in directly - same idiom the
      # pre-nesting version of this script used for zone_names.
      - action: script.irrigator_enqueue_or_publish
        data:
          topic: "irrigatorF4/cmd/upload/settings.json"
          payload: >-
            {% set watering = {
              'watering_percentage': states('input_number.irrigator_watering_percentage') | int(100),
              'schedule_active': existing_watering.get('schedule_active', true),
              'auto_adjustment_enabled': existing_watering.get('auto_adjustment_enabled', true),
              'default_manual_duration': states('input_number.irrigator_default_manual_duration') | int(5),
              'upper_limit': states('input_number.irrigator_upper_limit') | int(200),
              'lower_limit': states('input_number.irrigator_lower_limit') | int(40),
              'rain_forecast_probability_percent': states('input_number.irrigator_rain_forecast_probability') | int(70),
              'weatherapi_key': states('input_text.irrigator_weatherapi_key') | default('')
            } %}
            {% set location = {
              'location_known': existing_location.get('location_known', false),
              'latitude': existing_location.get('latitude', 0),
              'longitude': existing_location.get('longitude', 0),
              'city': existing_location.get('city', '')
            } %}
            {% set current_sensor = {
              'valve_current_base_level': existing_current_sensor.get('valve_current_base_level', 0),
              'pump_current_base_level': existing_current_sensor.get('pump_current_base_level', 0),
              'alert_pump_uc': is_state('input_boolean.irrigator_alert_pump_uc', 'on'),
              'alert_pump_oc': is_state('input_boolean.irrigator_alert_pump_oc', 'on'),
              'alert_valve_uc': is_state('input_boolean.irrigator_alert_valve_uc', 'on'),
              'alert_valve_oc': is_state('input_boolean.irrigator_alert_valve_oc', 'on')
            } %}
            {% set flow_meter = {
              'flow_meter_enabled': is_state('input_boolean.irrigator_flow_meter_enabled', 'on'),
              'expected_flow_rate_lpm': states('input_number.irrigator_expected_flow_rate_lpm') | int(0)
            } %}
            {% set base = {'Watering': watering, 'Location': location, 'Current_sensor': current_sensor, 'FlowMeter': flow_meter} %}
            {% set base_json = (base | tojson) %}
            {{ base_json[:-1] ~ ',"Zones":' ~ zn ~ '}' }}

  # ---------------------------------------------------------------------
  # HA -> device: create or overwrite one schedule record from the editor
  # panel (Schedule tab) and republish the FULL schedule.json - same
  # "read the whole list, mutate, republish the whole file" contract
  # cmd/upload/schedule.json requires everywhere else (no partial-update
  # topic exists for this file).
  #
  # Which record gets replaced: the index encoded in the picker's currently
  # selected option, e.g. "[3] Zone 3 - Trees left - Tue 06:00 - 9min" -> 3,
  # an index into sensor.irrigator_schedule's `records` list in its natural
  # (unsorted) order - see "Irrigator - rebuild schedule editor dropdown
  # options" in irrigator_automations.yaml for how that string is built, and
  # the "#" column in the "Device Schedule" table (garden_tab.yaml) for the
  # same index shown regardless of the table's current sort order. "+ Add
  # new" has no leading "[", which parses to -1, meaning append a new
  # record instead of replacing one.
  # ---------------------------------------------------------------------
  irrigator_schedule_save:
    alias: "Irrigator: save schedule record from editor panel"
    sequence:
      - variables:
          picker: "{{ states('input_select.irrigator_schedule_picker') }}"
          idx: "{{ (picker.split(']')[0].split('[')[1] | int) if picker.startswith('[') else -1 }}"
          # Builds on a schedule edit still sitting unsent in the offline queue (if any) rather
          # than sensor.irrigator_schedule, which only updates from the device's own echo - which
          # won't arrive until it's back online. Falls back to the last-known device schedule when
          # nothing's queued, same as before.
          records: >-
            {% set pending = (state_attr('sensor.irrigator_command_queue', 'items') or []) | selectattr('topic', 'eq', 'irrigatorF4/cmd/upload/schedule.json') | list %}
            {{ (pending[-1].payload | from_json) if pending else (state_attr('sensor.irrigator_schedule', 'records') or []) }}
          day_names: ["Mon", "Tue", "Wed", "Thu", "Fri", "Sat", "Sun"]
          new_record:
            zone: "{{ states('input_select.irrigator_edit_zone').split(' - ')[0] | int }}"
            day_of_week: "{{ day_names.index(states('input_select.irrigator_edit_day')) + 1 }}"
            start_time: "{{ states('input_datetime.irrigator_edit_start_time')[:5] }}"
            duration_min: "{{ states('input_number.irrigator_edit_duration_min') | int(5) }}"
            active: "{{ is_state('input_boolean.irrigator_edit_active', 'on') }}"
      - variables:
          new_records: >-
            {{ (records[:idx] + [new_record] + records[idx+1:]) if 0 <= idx < (records | length) else (records + [new_record]) }}
      - if:
          - condition: template
            value_template: "{{ (new_records | length) > 32 }}"
        then:
          - action: persistent_notification.create
            data:
              title: "Irrigator schedule NOT saved"
              message: >-
                This would put the schedule at {{ new_records | length }}
                time blocks, over the device's 32-record limit. Delete an
                existing record first.
        else:
          - action: script.irrigator_enqueue_or_publish
            data:
              topic: "irrigatorF4/cmd/upload/schedule.json"
              payload: "{{ new_records | tojson }}"
          - action: input_select.select_option
            target:
              entity_id: input_select.irrigator_schedule_picker
            data:
              option: "+ Add new"

  # HA -> device: remove the record currently selected in the editor panel
  # and republish the full schedule.json, same contract as the save script
  # above. No-op (with a notification) if "+ Add new" is selected, since
  # there's nothing to delete.
  irrigator_schedule_delete:
    alias: "Irrigator: delete schedule record selected in editor panel"
    sequence:
      - variables:
          picker: "{{ states('input_select.irrigator_schedule_picker') }}"
          idx: "{{ (picker.split(']')[0].split('[')[1] | int) if picker.startswith('[') else -1 }}"
          # Same "build on the still-queued edit if there is one" logic as irrigator_schedule_save.
          records: >-
            {% set pending = (state_attr('sensor.irrigator_command_queue', 'items') or []) | selectattr('topic', 'eq', 'irrigatorF4/cmd/upload/schedule.json') | list %}
            {{ (pending[-1].payload | from_json) if pending else (state_attr('sensor.irrigator_schedule', 'records') or []) }}
      - if:
          - condition: template
            value_template: "{{ idx < 0 }}"
        then:
          - action: persistent_notification.create
            data:
              title: "Irrigator: nothing to delete"
              message: >-
                Pick an existing record from "Schedule Record" first -
                "+ Add new" has nothing to delete.
        else:
          - action: script.irrigator_enqueue_or_publish
            data:
              topic: "irrigatorF4/cmd/upload/schedule.json"
              payload: "{{ (records[:idx] + records[idx+1:]) | tojson }}"
          - action: input_select.select_option
            target:
              entity_id: input_select.irrigator_schedule_picker
            data:
              option: "+ Add new"
