igrowing/HA-Irrigator/src/domain/Settings.h

#pragma once

#include <stddef.h>
#include <stdint.h>

#include "board_config.h"

namespace irrigator::domain {

struct Settings {
    int16_t wateringPercentage = board::DEFAULT_WATERING_PERCENTAGE;
    char zoneNames[board::ZONE_COUNT][16] = {};
    // Disabled zones are excluded from all watering activity — scheduled, manual (local UI), and
    // MQTT cmd/run alike; see enqueueOrStart() in main.ino, the single choke point all three
    // funnel through.
    bool zoneEnabled[board::ZONE_COUNT] = {};
    bool scheduleActive = true;
    uint8_t defaultManualDuration = board::DEFAULT_MANUAL_DURATION_MINUTES;

    // True-RMS current "base" per sensor (see drivers::CurrentSensor::sampleRmsMv) — a virtual
    // reference level, not a real mA value, captured by MQTT cmd/calibrate while a zone/pump is
    // under normal running load. 0 means "never calibrated": main.ino's over/undercurrent checks
    // skip a sensor entirely until this is set. Device-owned, same as
    // location_known/latitude/longitude/city below — only cmd/calibrate ever writes these, never
    // an uploaded settings.json (see mergeSettings's doc below).
    uint16_t valveCurrentBaseLevel = 0;
    uint16_t pumpCurrentBaseLevel = 0;
    // Per-fault enable toggles for drainCurrentBurstResults()'s current-fault alerting (main.ino) —
    // independent of, and in addition to, that check's own base-calibrated (!=0) gate. All default
    // true so upgrading an existing settings.json (missing these fields) preserves today's
    // unconditional-when-calibrated alerting behavior. Editable from the on-device Settings menu
    // (above "Calibrate CS") and from HA; lives in settings.json's Current_sensor group.
    bool alertPumpUc = true;
    bool alertPumpOc = true;
    bool alertValveUc = true;
    bool alertValveOc = true;

    // Weather-based auto-adjustment. Master on/off switch for the whole feature (both the
    // percentage recalculation, including the forecast-rain term) — defaults true so upgrading an existing
    // settings.json (missing this field) preserves today's behavior instead of silently disabling
    // a feature that was already running. Geolocation resolution (tryGeolocateIfDue in main.ino)
    // is intentionally NOT gated by this: it's cheap, one-time, and its result (city/coordinates)
    // is still worth displaying even with adjustment disabled.
    bool autoAdjustmentEnabled = true;
    // locationKnown is an explicit flag rather
    // than inferring "unset" from lat/lon both being 0 — (0,0) is a real place (Gulf of Guinea),
    // so a sentinel value would be ambiguous with a genuine reading there.
    bool locationKnown = false;
    float latitude = 0.0f;
    float longitude = 0.0f;
    char city[32] = {};
    // Deliberately NOT here: a "last successful auto-adjustment date" field. It's in-RAM only
    // (see main.ino's lastWeatherUpdateDate) so a power cycle naturally re-triggers today's cycle
    // instead of remembering it was already done — the auto-adjustment window (3h before the
    // first scheduled watering) is designed to tolerate re-running, not to be skipped after a
    // reboot.
    int16_t upperLimitPercent = board::AUTOADJUSTMENT_DEFAULT_UPPER_LIMIT_PERCENT;
    int16_t lowerLimitPercent = board::AUTOADJUSTMENT_DEFAULT_LOWER_LIMIT_PERCENT;
    // Step 1's forecast-rain threshold (see domain::effectiveRainMm): the forecast counts as fallen
    // rain only at/over this probability — whole percent, matching the rotary UI's existing
    // integer-only editing convention (no field in this project is rotary-edited as a float today).
    int16_t rainForecastProbabilityPercent = board::AUTOADJUSTMENT_DEFAULT_RAIN_FORECAST_PROBABILITY_PERCENT;
    // WeatherAPI.com key, used only as the Phase 4 fallback when Open-Meteo (no key required)
    // fails. Note: sensor.irrigator_settings in the HA package mirrors the whole settings.json
    // payload as attributes (see homeassistant/packages/irrigator.yaml), so this key is visible
    // there too — not selectively excludable without reworking that sensor.
    char weatherApiKey[48] = {};

    // TUF-2000M flow-meter feature (the tuf2000 library, board_config.h's FLOW_METER_*
    // constants) — settings.json's FlowMeter group. Default true, same rationale as
    // autoAdjustmentEnabled: upgrading an existing settings.json shouldn't silently disable a
    // feature that was already running. Scoped specifically to the flow-rate anomaly check
    // (main.ino) — it does NOT gate the underlying Modbus polling or the raw /flow telemetry,
    // which have run unconditionally since this feature's earlier stages and aren't changing now.
    bool flowMeterEnabled = true;
    // Expected steady-state flow rate while a zone is watering, in liters/minute — the "base" the
    // anomaly check compares live readings against (±50%, flow_high/flow_low faults). Unlike the
    // current sensor's valveCurrentBaseLevel, there's no ESP32-side calibration step to capture
    // this automatically (the TUF-2000M is a self-calibrated ultrasonic meter with no zero-offset
    // of its own either) — the user sets it directly, e.g. from a value already seen on
    // the flow_rate_lpm cmd/meter reports during a normal run. 0 means "not configured": no check runs.
    // A single value for the whole device rather than per-zone, the same simplification the
    // current sensor's shared valveCurrentBaseLevel already makes — only one zone ever waters at a
    // time — though unlike current draw, flow rate can genuinely differ a lot between a drip zone
    // and a sprinkler zone; a system with drastically different per-zone flow rates would need a
    // per-zone threshold, which this does not provide.
    int16_t expectedFlowRateLpm = 0;
};

Settings makeDefaultZones();
bool validateSettings(const Settings& settings);

// settings.json is nested into five top-level groups — Zones (per-zone name/enabled, keyed "1".."N",
// same shape as before), Location (location_known/latitude/longitude/city), Current_sensor
// (valve/pump_current_base_level, alertPumpUc/Oc/ValveUc/Oc), FlowMeter
// (flow_meter_enabled/expected_flow_rate_lpm), Watering (everything else: watering
// percentage, schedule_active, default_manual_duration, auto_adjustment_enabled, upper/lower limit,
// rain_forecast_probability_percent, weatherapi_key). parseSettings() additionally
// falls back to each field's old flat top-level key when its new nested key is absent, so a
// pre-restructuring settings.json still loads its real values instead of resetting to defaults —
// see main.ino's boot-time load, which persists once right after a successful parse to rewrite the
// file in the new nested shape (self-migrating; the flat fallback is then never exercised again on
// that device). mergeSettings() (below) does NOT have this fallback — by the time an upload can
// reach it, HA is publishing nested settings.json too.
//
// Missing fields fall back to makeDefaultSettings() values (this is the spec-defined default,
// not a guess). Rejects (returns false) only on malformed JSON or values validateSettings()
// rejects, e.g. an out-of-range watering percentage.
bool parseSettings(const char* json, size_t length, Settings& out);
size_t serializeSettings(const Settings& settings, char* buffer, size_t bufferSize);

// Same field-by-field merge semantics as ConfigStore.h's mergeConfig(): a field present in
// `json` (at its nested group path, e.g. "Watering.watering_percentage") with a non-null,
// non-empty value is validated on its own and applied to `out` only if it individually passes; a
// field that's missing, null, an empty string, or fails its own check instead keeps `existing`'s
// value, and (only for the fails-its-own-check case) its dotted path is appended,
// comma-separated, into `rejectedFieldsOut`. Zones is merged per zone index, so an upload naming
// only zone 3 doesn't disturb zones 1, 2, 4... Watering.upper_limit/lower_limit are validated
// together (upper >= lower), matching validateSettings().
//
// Location.location_known/latitude/longitude/city, and Current_sensor.valve/pump_current_base_level,
// are device-owned (the former populated only by the device's own geolocation resolution — see
// main.ino's resolveGeolocationIfNeeded() — the latter only by cmd/calibrate) and are deliberately
// never read from `json` here; `out` always keeps `existing`'s values for those six. Callers
// that also guard schedule_active/auto_adjustment_enabled as device-owned (see main.ino's
// handleMqttUpload) still need to do that themselves after calling this — those two are still
// merged like any other field here.
//
// Returns false only when `json` doesn't parse as a JSON object at all — there's nothing to
// merge from then, and `out`/`rejectedFieldsOut` are left untouched.
bool mergeSettings(const Settings& existing,
                    const char* json,
                    size_t length,
                    Settings& out,
                    char* rejectedFieldsOut,
                    size_t rejectedFieldsOutSize);

}  // namespace irrigator::domain
