igrowing/HA-Irrigator/src/domain/IrrigationStateMachine.cpp

#include "IrrigationStateMachine.h"

#include "board_config.h"

namespace irrigator::domain {

static uint32_t durationToMs(uint16_t minutes) {
    return static_cast<uint32_t>(minutes) * 60UL * 1000UL;
}

bool IrrigationStateMachine::start(const WateringRequest& request, uint32_t nowMs) {
    if (!canStartImmediately() || request.durationMin == 0 || request.zone > board::ZONE_COUNT) {
        return false;
    }

    current_ = request;
    pumpGraceStartedAtMs_ = 0;
    wateringStartedAtMs_ = nowMs;
    state_ = request.zone == 0 ? IrrigationState::PumpOnly : IrrigationState::Watering;
    return true;
}

void IrrigationStateMachine::abort(uint32_t nowMs) {
    // Zone+pump run in progress (valve may or may not have opened yet): same transition tick()
    // uses at natural end-of-duration — pump keeps running its graceful-shutdown tail, only the
    // valve (implied by leaving Watering) closes right away.
    if (current_.zone != 0 &&
        (state_ == IrrigationState::Watering)) {
        pumpGraceStartedAtMs_ = nowMs;
        state_ = IrrigationState::PumpGracePeriod;
        return;
    }

    current_ = {};
    wateringStartedAtMs_ = 0;
    pumpGraceStartedAtMs_ = 0;
    state_ = IrrigationState::Idle;
}

void IrrigationStateMachine::tick(uint32_t nowMs) {
    switch (state_) {
        case IrrigationState::Watering:
            if (nowMs - wateringStartedAtMs_ >= durationToMs(current_.durationMin)) {
                pumpGraceStartedAtMs_ = nowMs;
                state_ = IrrigationState::PumpGracePeriod;
            }
            break;
        case IrrigationState::PumpOnly:
            if (nowMs - wateringStartedAtMs_ >= durationToMs(current_.durationMin)) {
                abort(nowMs);
            }
            break;
        case IrrigationState::PumpGracePeriod:
            if (nowMs - pumpGraceStartedAtMs_ >= board::PUMP_GRACEFUL_SHUTDOWN_MS) {
                abort(nowMs);
            }
            break;
        case IrrigationState::Idle:
        default:
            break;
    }
}

IrrigationSnapshot IrrigationStateMachine::snapshot(uint32_t nowMs) const {
    IrrigationSnapshot shot;
    shot.state = state_;
    shot.activeZone = current_.zone;
    shot.pumpOn = state_ != IrrigationState::Idle;

    if (state_ == IrrigationState::Watering || state_ == IrrigationState::PumpOnly) {
        shot.elapsedMs = nowMs - wateringStartedAtMs_;
        const uint32_t total = durationToMs(current_.durationMin);
        shot.remainingMs = shot.elapsedMs >= total ? 0 : total - shot.elapsedMs;
    }
    return shot;
}

}  // namespace irrigator::domain
