igrowing/HA-Irrigator/src/domain/AutoAdjustment.cpp

#include "AutoAdjustment.h"

namespace irrigator::domain {

int16_t computeAutoCorrectedPercentage(float avgPastTempC,
                                       float rainMm,
                                       int16_t lowerLimitPercent,
                                       int16_t upperLimitPercent) {
    float percentage = 100.0f + (avgPastTempC - irrigator::board::AUTOADJUSTMENT_BASE_TEMP_C) * irrigator::board::AUTOADJUSTMENT_DEFAULT_TEMP_MODIFIER_PCT_PER_DEGREE -
                        rainMm * irrigator::board::AUTOADJUSTMENT_DEFAULT_RAIN_MODIFIER_PCT_PER_MM;

    if (percentage < static_cast<float>(lowerLimitPercent)) {
        return 0;  // Below the lower limit skips the cycle entirely (spec Step 5), not clamps to it.
    }
    if (percentage > static_cast<float>(upperLimitPercent)) {
        percentage = static_cast<float>(upperLimitPercent);
    }
    if (percentage < 0.0f) {
        percentage = 0.0f;
    }
    return static_cast<int16_t>(percentage + 0.5f);
}

float effectiveRainMm(float rainPastDaysMm,
                      float rainProbabilityPercent,
                      float rainAmountNextWindowMm,
                      int16_t thresholdProbabilityPercent) {
    const bool forecastCounts =
        rainProbabilityPercent >= static_cast<float>(thresholdProbabilityPercent);
    return forecastCounts ? rainPastDaysMm + rainAmountNextWindowMm : rainPastDaysMm;
}

}  // namespace irrigator::domain
