igrowing/HA-Irrigator/src/domain/DstRules.cpp

#include "DstRules.h"

#include "CalendarMath.h"
#include "board_config.h"

namespace irrigator::domain {

namespace {

int64_t lastSundayOfMonthEpochUtc(int year, unsigned month, int hourUtc) {
    // Only ever called for March/October, both 31-day months.
    int64_t days = daysFromCivil(year, month, 31);
    days -= weekdayFromDays(days);  // Step back to the Sunday on/before the month's last day.
    return days * 86400 + static_cast<int64_t>(hourUtc) * 3600;
}

}  // namespace

bool isEuDstActive(int64_t utcEpochSeconds) {
    const int64_t days =
        utcEpochSeconds >= 0 ? utcEpochSeconds / 86400 : (utcEpochSeconds - 86399) / 86400;
    const CivilDate civil = civilFromDays(days);

    const int64_t marchTransition = lastSundayOfMonthEpochUtc(civil.year, 3, 1);
    const int64_t octoberTransition = lastSundayOfMonthEpochUtc(civil.year, 10, 1);

    return utcEpochSeconds >= marchTransition && utcEpochSeconds < octoberTransition;
}

int8_t standardUtcOffsetHoursFromCurrent(int32_t currentOffsetSeconds, int64_t utcEpochSeconds) {
    const int32_t standardSeconds =
        currentOffsetSeconds - (isEuDstActive(utcEpochSeconds) ? 3600 : 0);
    // Integer division truncates toward zero in C++, which is the symmetric behaviour we want for
    // sub-hour zones: +05:30 -> +5 and -05:30 -> -5, both landing on the nearer whole hour on the
    // UTC side rather than one direction rounding away.
    int32_t hours = standardSeconds / 3600;
    if (hours < board::TIMEZONE_OFFSET_MIN_HOURS) {
        hours = board::TIMEZONE_OFFSET_MIN_HOURS;
    } else if (hours > board::TIMEZONE_OFFSET_MAX_HOURS) {
        hours = board::TIMEZONE_OFFSET_MAX_HOURS;
    }
    return static_cast<int8_t>(hours);
}

}  // namespace irrigator::domain
