igrowing/HA-Irrigator/src/domain/UiStateMachine.cpp

#include "UiStateMachine.h"

#include <stdio.h>

#include "DurationAdjuster.h"
#include "board_config.h"

namespace irrigator::domain {

uint16_t UiStateMachine::stepIndex(uint16_t current, uint16_t count, bool forward) {
    if (count == 0) {
        return 0;
    }
    if (forward) {
        return static_cast<uint16_t>((current + 1) % count);
    }
    return static_cast<uint16_t>((current + count - 1) % count);
}

uint8_t UiStateMachine::nextZone(uint8_t current, bool forward, const Context& ctx) {
    uint8_t zone = current;
    for (uint8_t attempt = 0; attempt <= board::ZONE_COUNT; ++attempt) {
        zone = forward ? static_cast<uint8_t>((zone + 1) % (board::ZONE_COUNT + 1))
                       : static_cast<uint8_t>((zone + board::ZONE_COUNT) % (board::ZONE_COUNT + 1));
        if (zone == 0 || ctx.zoneEnabled[zone - 1]) {
            return zone;
        }
    }
    return 0;  // Every zone disabled: PUMP is the only reachable option left.
}

void UiStateMachine::armTimeout(uint32_t nowMs) {
    active_ = true;
    interactionDeadlineMs_ = nowMs + board::ACTIVE_INTERACTION_TIMEOUT_MS;
}

void UiStateMachine::enterDisplayOff() {
    screen_ = UiScreen::DisplayOff;
    active_ = false;
    editing_ = false;
    selectedIndex_ = 0;
}

void UiStateMachine::wake(uint32_t nowMs) {
    armTimeout(nowMs);
    screen_ = UiScreen::Normal;
    selectedIndex_ = 0;
    editing_ = false;
}

void UiStateMachine::enterFactoryResetConfirm(uint32_t nowMs) {
    armTimeout(nowMs);
    screen_ = UiScreen::FactoryResetConfirm;
    factoryResetConfirmYes_ = false;
    editing_ = false;
}

void UiStateMachine::showFactoryResetResult(bool success, uint32_t nowMs) {
    armTimeout(nowMs);
    screen_ = UiScreen::FactoryResetResult;
    factoryResetSucceeded_ = success;
}

void UiStateMachine::showCalibrateResult(bool valveSucceeded,
                                         uint16_t valveBaseLevel,
                                         const char* valveMessage,
                                         bool pumpSucceeded,
                                         uint16_t pumpBaseLevel,
                                         const char* pumpMessage,
                                         uint32_t nowMs) {
    armTimeout(nowMs);
    screen_ = UiScreen::CalibrateResult;
    calibrateValveSucceeded_ = valveSucceeded;
    calibrateValveBaseLevel_ = valveBaseLevel;
    snprintf(calibrateValveMessage_, sizeof(calibrateValveMessage_), "%s", valveMessage == nullptr ? "" : valveMessage);
    calibratePumpSucceeded_ = pumpSucceeded;
    calibratePumpBaseLevel_ = pumpBaseLevel;
    snprintf(calibratePumpMessage_, sizeof(calibratePumpMessage_), "%s", pumpMessage == nullptr ? "" : pumpMessage);
}

void UiStateMachine::showScheduleActionResult(bool success, uint32_t nowMs) {
    armTimeout(nowMs);
    screen_ = UiScreen::ScheduleActionResult;
    scheduleActionSucceeded_ = success;
}

void UiStateMachine::showQueueAddResult(const char* zoneLabel, uint16_t duration, bool success, uint32_t nowMs) {
    armTimeout(nowMs);
    screen_ = UiScreen::QueueAddResult;
    snprintf(queueAddZoneLabel_, sizeof(queueAddZoneLabel_), "%s", zoneLabel == nullptr ? "" : zoneLabel);
    queueAddDuration_ = duration;
    queueAddSucceeded_ = success;
}

void UiStateMachine::tick(uint32_t nowMs) {
    if (active_ && screen_ != UiScreen::DisplayOff && nowMs >= interactionDeadlineMs_) {
        enterDisplayOff();
    }
}

UiIntent UiStateMachine::handleInput(UiInputEvent event, const Context& ctx, uint32_t nowMs) {
    if (screen_ == UiScreen::DisplayOff) {
        wake(nowMs);
        return {};
    }

    armTimeout(nowMs);

    switch (screen_) {
        case UiScreen::Normal:
            return handleNormal(event, ctx);
        case UiScreen::ZonePicker:
            return handleZonePicker(event, ctx);
        case UiScreen::DurationPicker:
            return handleDurationPicker(event, ctx);
        case UiScreen::StopConfirm:
            return handleStopConfirm(event);
        case UiScreen::MenuMain:
            return handleMenuMain(event, ctx);
        case UiScreen::MenuQueue:
            return handleMenuQueue(event, ctx);
        case UiScreen::MenuScheduleRoot:
            return handleMenuScheduleRoot(event);
        case UiScreen::MenuSchedule:
            return handleMenuSchedule(event, ctx);
        case UiScreen::ScheduleAdd:
            return handleScheduleAdd(event);
        case UiScreen::ScheduleDelete:
            return handleScheduleDelete(event, ctx);
        case UiScreen::ScheduleDeleteConfirm:
            return handleScheduleDeleteConfirm(event);
        case UiScreen::ScheduleActionResult:
            return handleScheduleActionResult(event);
        case UiScreen::MenuSettings:
            return handleMenuSettings(event, ctx);
        case UiScreen::MenuInfo:
            return handleMenuInfo(event);
        case UiScreen::MenuTestAll:
            return handleMenuTestAll(event);
        case UiScreen::RestartConfirm:
            return handleYesNoConfirm(event, restartConfirmYes_, UiIntentType::RestartDevice);
        case UiScreen::FactoryResetConfirm:
            return handleYesNoConfirm(event, factoryResetConfirmYes_, UiIntentType::FactoryReset);
        case UiScreen::CalibrateConfirm:
            return handleYesNoConfirm(event, calibrateConfirmYes_, UiIntentType::CalibrateCurrentSensors);
        case UiScreen::CalibrateResult:
        case UiScreen::QueueAddResult:
            return handleDeadEndResult(event);
        case UiScreen::FactoryResetResult:
        case UiScreen::DisplayOff:
        default:
            return {};
    }
}

UiIntent UiStateMachine::handleNormal(UiInputEvent event, const Context& ctx) {
    // Rotation/click work the same whether or not a run is already active — while watering, this
    // is how the user picks the *next* watering to append to the queue (see UiIntentType::
    // StartWatering below, and enqueueOrStart() in main.ino which already pushes every request
    // through the queue regardless of whether it can start immediately). handleDurationPicker's
    // Click is what tells the two cases apart and shows the "Added to queue" confirmation.
    //
    // Rotate relative to whatever the Normal screen is currently showing (the running zone while
    // watering, the next scheduled zone when idle+scheduled, PUMP otherwise) rather than always
    // starting from PUMP. The three cases and their precedence mirror IrrigatorUi::renderNormal's
    // `running`/`scheduled`/else chain for the big middle line exactly — if that chain changes,
    // this one has to change with it, or the knob starts moving relative to a zone that isn't the
    // one on screen.
    const bool scheduled = ctx.scheduleActive && ctx.nextScheduledZone != 0;
    const uint8_t displayedZone =
        ctx.wateringActive ? ctx.activeZone : (scheduled ? ctx.nextScheduledZone : 0);

    switch (event) {
        case UiInputEvent::Clockwise:
            pendingZone_ = nextZone(displayedZone, true, ctx);
            screen_ = UiScreen::ZonePicker;
            break;
        case UiInputEvent::CounterClockwise:
            pendingZone_ = nextZone(displayedZone, false, ctx);
            screen_ = UiScreen::ZonePicker;
            break;
        case UiInputEvent::Click:
            // While watering, a click with no prior rotation means "another run of the zone I'm
            // looking at" — the running zone is what the screen is showing, so skipping the zone
            // picker has to land on that zone, not on PUMP. Idle keeps the pump-only default:
            // there the screen shows PUMP too (see renderNormal's else branch), so a bare click
            // still matches what's displayed.
            pendingZone_ = ctx.wateringActive ? ctx.activeZone : 0;
            pendingDuration_ = ctx.defaultManualDuration;
            screen_ = UiScreen::DurationPicker;
            break;
        case UiInputEvent::LongClick:
            screen_ = UiScreen::MenuMain;
            selectedIndex_ = 0;
            break;
    }
    return {};
}

UiIntent UiStateMachine::handleZonePicker(UiInputEvent event, const Context& ctx) {
    switch (event) {
        case UiInputEvent::Clockwise:
            pendingZone_ = nextZone(pendingZone_, true, ctx);
            break;
        case UiInputEvent::CounterClockwise:
            pendingZone_ = nextZone(pendingZone_, false, ctx);
            break;
        case UiInputEvent::Click:
            pendingDuration_ = ctx.defaultManualDuration;
            screen_ = UiScreen::DurationPicker;
            break;
        case UiInputEvent::LongClick:
            screen_ = UiScreen::MenuMain;
            selectedIndex_ = 0;
            break;
    }
    return {};
}

UiIntent UiStateMachine::handleDurationPicker(UiInputEvent event, const Context& ctx) {
    UiIntent intent;
    switch (event) {
        case UiInputEvent::Clockwise:
            pendingDuration_ = adjustManualDuration(pendingDuration_, RotationDirection::Clockwise);
            break;
        case UiInputEvent::CounterClockwise:
            pendingDuration_ =
                adjustManualDuration(pendingDuration_, RotationDirection::CounterClockwise);
            break;
        case UiInputEvent::Click:
            intent.type = UiIntentType::StartWatering;
            intent.zone = pendingZone_;
            intent.duration = pendingDuration_;
            // Flags to main.ino whether this request is going behind an already-running watering
            // (queued) rather than starting immediately — main.ino echoes it back via
            // showQueueAddResult() after actually pushing the request, which is what advances
            // screen_ to QueueAddResult; a queue-full drop still needs that screen (to say so), so
            // this deliberately doesn't jump to Normal itself when queued, same reasoning as
            // handleCalibrateConfirm leaving CalibrateConfirm on screen for showCalibrateResult to
            // override.
            intent.boolValue = ctx.wateringActive;
            if (!ctx.wateringActive) {
                screen_ = UiScreen::Normal;
            }
            break;
        case UiInputEvent::LongClick:
            screen_ = UiScreen::Normal;  // Cancel, discard.
            break;
    }
    return intent;
}

UiIntent UiStateMachine::handleStopConfirm(UiInputEvent event) {
    UiIntent intent;
    switch (event) {
        case UiInputEvent::Clockwise:
        case UiInputEvent::CounterClockwise:
            stopConfirmYes_ = !stopConfirmYes_;
            break;
        case UiInputEvent::Click:
            if (stopConfirmYes_) {
                intent.type = stopAllPending_ ? UiIntentType::StopAllWatering : UiIntentType::AbortWatering;
            }
            stopConfirmYes_ = false;
            stopAllPending_ = false;
            screen_ = UiScreen::Normal;
            break;
        case UiInputEvent::LongClick:
            stopConfirmYes_ = false;
            stopAllPending_ = false;
            screen_ = UiScreen::Normal;
            break;
    }
    return intent;
}

// Shared by FactoryResetConfirm/RestartConfirm/CalibrateConfirm — all three are the same Yes/No
// gesture (CW/CCW toggles the selection, Click on YES emits confirmedIntentType and Click on NO or
// LongClick cancels), differing only in which flag they toggle and what they emit. Confirmed does
// NOT transition screen_ itself (unlike cancel) — the caller (main.ino's handleUiIntent) is
// expected to perform the action and then force the next screen (e.g. showCalibrateResult()),
// same reasoning as handleDeadEndResult below. StopConfirm stays separate: it also branches on
// stopAllPending_ to pick between two intent types, which doesn't fit this single-intent shape.
UiIntent UiStateMachine::handleYesNoConfirm(UiInputEvent event, bool& yesSelected, UiIntentType confirmedIntentType) {
    UiIntent intent;
    switch (event) {
        case UiInputEvent::Clockwise:
        case UiInputEvent::CounterClockwise:
            yesSelected = !yesSelected;
            break;
        case UiInputEvent::Click:
            if (yesSelected) {
                intent.type = confirmedIntentType;
            } else {
                screen_ = UiScreen::Normal;
            }
            yesSelected = false;
            break;
        case UiInputEvent::LongClick:
            yesSelected = false;
            screen_ = UiScreen::Normal;
            break;
    }
    return intent;
}

// Shared by CalibrateResult and QueueAddResult — both are a single dead-end "OK" action, not a
// navigable list: Clockwise/CounterClockwise are no-ops (nothing to scroll to), and either Click
// or LongClick dismisses back to Normal. main.ino is expected to have already called
// showCalibrateResult()/showQueueAddResult() with the screen's content before the intent
// round-trip that got here lands. ScheduleActionResult stays separate: it restores a specific
// (screen, index) instead of always landing on Normal, which doesn't fit this shape.
UiIntent UiStateMachine::handleDeadEndResult(UiInputEvent event) {
    if (event == UiInputEvent::Click || event == UiInputEvent::LongClick) {
        screen_ = UiScreen::Normal;
        selectedIndex_ = 0;
    }
    return {};
}

UiStateMachine::MenuMainLayout UiStateMachine::menuMainLayout(bool wateringActive) {
    if (wateringActive) {
        return {8, 0, 1, 2, 3, 4, 5, 6, 7};
    }
    return {5, 0, 0, 0, 0, 1, 2, 3, 4};
}

UiIntent UiStateMachine::handleMenuMain(UiInputEvent event, const Context& ctx) {
    // Item order, matching IrrigatorUi::renderMenuMain: [Queue, Stop, Stop all] (watering only),
    // Schedule, Test all zones, Settings, Info, BACK.
    const MenuMainLayout layout = menuMainLayout(ctx.wateringActive);
    UiIntent intent;

    switch (event) {
        case UiInputEvent::Clockwise:
            selectedIndex_ = stepIndex(selectedIndex_, layout.itemCount, true);
            break;
        case UiInputEvent::CounterClockwise:
            selectedIndex_ = stepIndex(selectedIndex_, layout.itemCount, false);
            break;
        case UiInputEvent::Click: {
            if (ctx.wateringActive && selectedIndex_ == layout.queueIndex) {
                screen_ = UiScreen::MenuQueue;
                selectedIndex_ = 0;
            } else if (ctx.wateringActive && selectedIndex_ == layout.stopIndex) {
                stopConfirmYes_ = false;
                stopAllPending_ = false;
                screen_ = UiScreen::StopConfirm;
            } else if (ctx.wateringActive && selectedIndex_ == layout.stopAllIndex) {
                stopConfirmYes_ = false;
                stopAllPending_ = true;
                screen_ = UiScreen::StopConfirm;
            } else if (selectedIndex_ == layout.scheduleIndex) {
                screen_ = UiScreen::MenuScheduleRoot;
                selectedIndex_ = 0;
            } else if (selectedIndex_ == layout.testAllIndex) {
                screen_ = UiScreen::MenuTestAll;
                selectedIndex_ = 0;
            } else if (selectedIndex_ == layout.settingsIndex) {
                screen_ = UiScreen::MenuSettings;
                selectedIndex_ = 0;
            } else if (selectedIndex_ == layout.infoIndex) {
                screen_ = UiScreen::MenuInfo;
                selectedIndex_ = 0;
            } else if (selectedIndex_ == layout.backIndex) {
                screen_ = UiScreen::Normal;
                selectedIndex_ = 0;
            }
            break;
        }
        case UiInputEvent::LongClick:
            screen_ = UiScreen::Normal;
            selectedIndex_ = 0;
            break;
    }
    return intent;
}

// Read-only, same shape as MenuInfo: the queue can only be viewed here (per spec, on-device we can
// only "stop all" blindly), so only the trailing BACK row is clickable — the data rows just scroll
// past. With an empty queue, queueMenuItemCount(0) == 1, so BACK is the only row and stepIndex's
// count==1 wraparound keeps selectedIndex_ pinned at 0 regardless of rotation.
UiIntent UiStateMachine::handleMenuQueue(UiInputEvent event, const Context& ctx) {
    const uint16_t itemCount = queueMenuItemCount(ctx.queueSize);
    const uint16_t backIndex = static_cast<uint16_t>(itemCount - 1);
    UiIntent intent;

    switch (event) {
        case UiInputEvent::Clockwise:
            selectedIndex_ = stepIndex(selectedIndex_, itemCount, true);
            break;
        case UiInputEvent::CounterClockwise:
            selectedIndex_ = stepIndex(selectedIndex_, itemCount, false);
            break;
        case UiInputEvent::Click:
            if (selectedIndex_ == backIndex) {
                screen_ = UiScreen::MenuMain;
                selectedIndex_ = 0;
            }
            break;
        case UiInputEvent::LongClick:
            screen_ = UiScreen::MenuMain;
            selectedIndex_ = 0;
            break;
    }
    return intent;
}
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
