igrowing/HA-Irrigator/src/ui/IrrigatorUi.cpp

#include "IrrigatorUi.h"

#include "../drivers/Logger.h"
#include "board_config.h"

namespace irrigator::ui {

namespace {

const char* noText = "NO";
const char* yesText = "YES";
const int16_t noX = 35;
const int16_t yesX = 70;

void drawCentered(U8G2& display, uint8_t y, const char* text) {
    const uint16_t width = display.getStrWidth(text);
    const int16_t x = static_cast<int16_t>((128 - static_cast<int16_t>(width)) / 2);
    display.drawStr(x < 0 ? 0 : x, y, text);
}

// Deliberately narrower than IrrigationSnapshot::pumpOn (state_ != Idle, which also covers
// PumpGracePeriod — the pump lingering post-run with nothing actually active). The UI treats the
// grace tail as idle-equivalent: normal screen falls back to IDLE-READY/SCHEDULED, rotary ticks
// work again (a fresh pick hot-hands-off the still-spinning pump, same mechanism the queue
// already uses), and the menu drops "Stop"/"Stop all" since there's nothing left to abort.
bool isActivelyRunning(const ::irrigator::domain::IrrigationSnapshot& snapshot) {
    using ::irrigator::domain::IrrigationState;
    return snapshot.state == IrrigationState::Watering || snapshot.state == IrrigationState::PumpOnly;
}

}  // namespace

void IrrigatorUi::begin() {
    display_.begin();
    display_.setContrast(20);
    display_.clearBuffer();
    display_.sendBuffer();
    input_.begin();
    display_.setDisplayRotation(U8G2_R2);
    ::irrigator::drivers::Log.info("UI initialized (SSD1309 + rotary input)");
}

void IrrigatorUi::wake(uint32_t nowMs) {
    uiState_.wake(nowMs);
}

void IrrigatorUi::confirmFactoryReset(uint32_t nowMs) {
    uiState_.enterFactoryResetConfirm(nowMs);
}

void IrrigatorUi::showFactoryResetResult(bool success, uint32_t nowMs) {
    uiState_.showFactoryResetResult(success, nowMs);
    render(nowMs, RenderData{});
}

void IrrigatorUi::showCalibrateResult(bool valveSucceeded,
                                      uint16_t valveBaseLevel,
                                      const char* valveMessage,
                                      bool pumpSucceeded,
                                      uint16_t pumpBaseLevel,
                                      const char* pumpMessage,
                                      uint32_t nowMs) {
    uiState_.showCalibrateResult(
        valveSucceeded, valveBaseLevel, valveMessage, pumpSucceeded, pumpBaseLevel, pumpMessage, nowMs);
    render(nowMs, RenderData{});
}
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
