igrowing/HA-Irrigator/(commit log)

2026-07-10 Init. rev.
    [partitions.csv]
2026-07-11 Fix captive portal display
    [IrrigatorUi.cpp, main.ino]
2026-07-12 Revamp MQTT, bug fixes to queue and state machine
    [CalendarMath.cpp, CalendarMath.h, IrrigationStateMachine.cpp, IrrigationStateMachine.h, LedIndicator.cpp, LedIndicator.h, MqttService.cpp, MqttService.h]
2026-07-14 Add Reset to factory defaults
    [FactoryResetButton.cpp, FactoryResetButton.h, IrrigatorUi.cpp, IrrigatorUi.h, UiStateMachine.cpp, UiStateMachine.h, UiTypes.h, board_config.h]
2026-07-14 Clean debug prints, adjust UI
2026-07-15 Revamp MQTT, remove GPIO expander, bug fixes to queue and state machine
    [IrrigationStateMachine.cpp, IrrigationStateMachine.h, IrrigatorUi.cpp, IrrigatorUi.h, UiStateMachine.cpp, UiStateMachine.h, UiTypes.h, board_config.h]
2026-07-15 Fix valve control from MQTT and some UI improvements.
    [IrrigationStateMachine.cpp, IrrigationStateMachine.h, IrrigatorUi.cpp, MqttService.cpp, MqttService.h, board_config.h, main.ino]
2026-07-15 Make irrigator controllable during pump graceful shutdown period
2026-07-17 Fix display of adjacent zones in selection mode when schedule id active
    [IrrigatorUi.cpp, UiStateMachine.cpp, UiStateMachine.h, board_config.h, main.ino]
2026-07-18 Add Test all button, improve data loading from the irrigator to HA
2026-07-18 Fix race condition which reset the irrigator settings
    [irrigator.yaml]
2026-07-20 Add WiFi quality indicator on Irrigator device
2026-07-20 Add hardware documentation
    [irrigator box.stl, irrigator lid.stl, irrigator.kicad_pcb, irrigator.kicad_sch]
2026-07-21 Update schematics
    [irrigator.kicad_sch]
2026-07-26 Breath the LED while watering
2026-07-26 Make MQTT broker optional
    [CaptivePortalHtml.h, CaptivePortalService.cpp, ConfigStore.cpp, IrrigatorUi.cpp, MqttService.cpp, MqttService.h, board_config.h]
2026-07-30 Bug fix: Remove retained flag from some MQTT messages
    [MqttService.cpp, MqttService.h, main.ino]
2026-07-30 Add current measure and alerts
2026-08-02 Add current sensor calibration
2026-08-04 Add enable/disable UC/OC control for valve and pump
2026-08-04 Add-delete schedule items in device
2026-08-04 Prevent repetitive crash by compiler configuration
    [board_config.h]
2026-08-04 Fix current sensor base level representation in HA after settings.json refactoring
    [irrigator.yaml]
2026-08-09 Reduce stack footprint and increase stack size: this should prevent the crash in OTA update
    [Schedule.cpp, main.ino]
2026-08-09 Add crash core dump download and parsing, increase and optimize stack RAM, add backup/restore of configuration from HA
    [partitions.csv]
2026-08-18 Irrigator bug fix: while watering, continue zone count from the currently active one.
    [IrrigatorUi.cpp, UiStateMachine.cpp, UiStateMachine.h, board_config.h]
2026-08-22 Add wifiClient_.setNoDelay(true) to fix MQTT dropped messages
    [MqttService.cpp, board_config.h]
2026-08-22 Report failed watering start.
    [main.ino]
2026-09-01 Display correct weather adjustment status on HA restart.
    [irrigator.yaml]
2026-09-15 Shorten weather update to watering and add weather update in non-watering days
    [board_config.h, main.ino]
2026-09-19 Add reading from flow meter TUF-2000M
2026-09-19 Adapt watering coefficients. Switch to use ERA5 model of open-meteo
2026-09-21 Fix watering percentage publish on weather update.
    [board_config.h, main.ino]
2026-09-25 Integrate publish and display of totalizer from meter to HA. Remove flow rate from displaying
2026-10-04 Account forecast rain, do not skip the watering
    [AutoAdjustment.cpp, AutoAdjustment.h, IrrigatorUi.cpp, Settings.cpp, Settings.h, UiStateMachine.cpp, UiStateMachine.h, UiTypes.h]
2026-10-09 Replace built-in TUF-2000 driver with standaline lib, locally
    [Settings.h, board_config.h, main.ino]
2026-10-09 Replace local lib tuf2000 with pioarduino repo
    [board_config.h]
